metallarox/eload-60v/docs/reports/drc_report.txt

** Drc report for eload_4ch.kicad_pcb **
** Created on 2026-10-26T12:06:38 **
** Report includes: Errors, Warnings, Exclusions **

** Found 4 DRC violations **
[lib_footprint_mismatch]: Footprint 'TO-247-3_Horizontal_TabUp' does not match copy in library 'Package_TO_SOT_THT'
    Local override; warning
    @(94.5500 mm, 130.0000 mm): Footprint Q3
[lib_footprint_mismatch]: Footprint 'TO-247-3_Horizontal_TabUp' does not match copy in library 'Package_TO_SOT_THT'
    Local override; warning
    @(129.4500 mm, 74.0000 mm): Footprint Q2
[lib_footprint_mismatch]: Footprint 'TO-247-3_Horizontal_TabUp' does not match copy in library 'Package_TO_SOT_THT'
    Local override; warning
    @(118.5500 mm, 130.0000 mm): Footprint Q4
[lib_footprint_mismatch]: Footprint 'TO-247-3_Horizontal_TabUp' does not match copy in library 'Package_TO_SOT_THT'
    Local override; warning
    @(105.4500 mm, 74.0000 mm): Footprint Q1

** Found 0 unconnected pads **

** Found 0 Footprint errors **

** Ignored checks **
    - Footprint has no courtyard defined
    - Track endpoint not centered on via
    - Tuning profile track geometries
    - Footprint doesn't match symbol's footprint filters
    - Footprint component type doesn't match footprint pads

** End of Report **
