metallarox/eload-60v/docs/images/closed.png

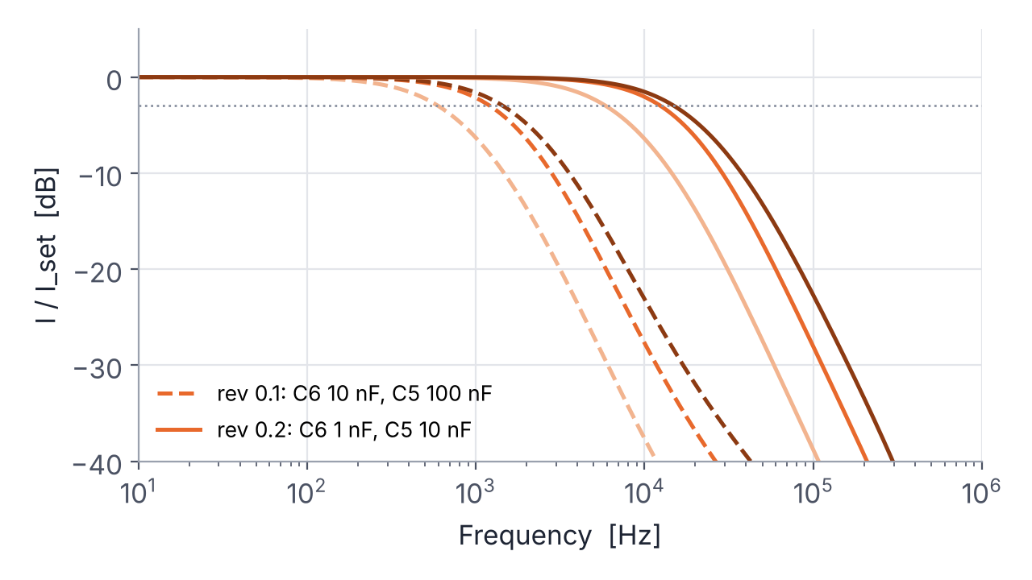
docs/images/closed.png
