metallarox/eload-60v/docs/images/render_bottom.png

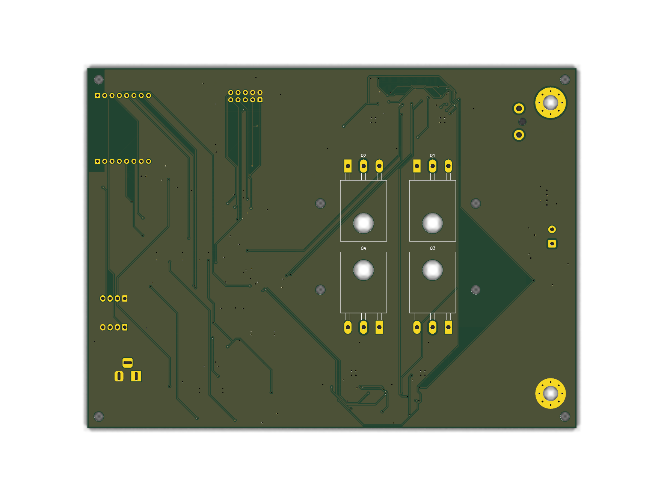
docs/images/render_bottom.png
