metallarox/eload-60v/hardware/bom/eload_4ch_bom.csv

Reference | Qty | Value | Footprint | MPN | Note
C1 | 1 | 100n 100V | Capacitor_SMD:C_1206_3216Metric |  | X7R
C2 | 1 | 10n 100V | Capacitor_SMD:C_1206_3216Metric
C3,C4,C7,C10,C13,C16,C20,C22,C28-C30,C32-C34,C36 | 15 | 100n | Capacitor_SMD:C_1206_3216Metric
C5,C8,C11,C14 | 4 | 10n C0G | Capacitor_SMD:C_1206_3216Metric |  | Setpoint filter 16.6 kHz (rev 0.2)
C6,C9,C12,C15 | 4 | 1n C0G | Capacitor_SMD:C_1206_3216Metric |  | Loop compensation rev 0.2: PM ~80 deg, BW 6-15 kHz
C17,C18,C40,C41 | 4 | 100n 50V | Capacitor_SMD:C_1206_3216Metric
C19,C21,C27,C35,C38,C39 | 6 | 10u 25V | Capacitor_SMD:C_1206_3216Metric |  | OLED decoupling
C23-C26 | 4 | 10n | Capacitor_SMD:C_1206_3216Metric |  | Debounce 100 us
C31,C37 | 2 | 1u | Capacitor_SMD:C_1206_3216Metric
C42,C43 | 2 | 22u 10V | Capacitor_SMD:C_1206_3216Metric
D1 | 1 | VS-30CTQ100S | Package_TO_SOT_SMD:TO-263-2 | VS-30CTQ100SPbF | Reverse polarity: conducts and blows F1 (check I2t)
D2 | 1 | SMCJ64CA | Diode_SMD:D_SMC | SMCJ64CA
D3 | 1 | SMAJ64CA | Diode_SMD:D_SMA | SMAJ64CA
D4 | 1 | SS34 | Diode_SMD:D_SMA | SS34
D5 | 1 | green | LED_SMD:LED_1206_3216Metric
F1 | 1 | 25A ATO | Fuse:Fuseholder_Blade_ATO_Littelfuse_Pudenz_2_Pin |  | ATO blade fuse 25 A
F2 | 1 | 1.5A | Fuse:Fuse_1206_3216Metric |  | PTC 1206, 1.5 A hold (WiFi buck + fan)
J1 | 1 | DUT+ | MountingHole:MountingHole_5.3mm_M5_Pad_Via |  | M5 stud, 25 A
J2 | 1 | DUT- | MountingHole:MountingHole_5.3mm_M5_Pad_Via |  | M5 stud, 25 A - ground star point
J3 | 1 | SENSE | TerminalBlock_Phoenix:TerminalBlock_Phoenix_MKDS-1,5-2_1x02_P5.00mm_Horizontal |  | 1=SENSE+ 2=SENSE-
J4 | 1 | D1mini L | Connector_PinSocket_2.54mm:PinSocket_1x08_P2.54mm_Vertical |  | RST A0 D0(GPIO16) D5(14) D6(12) D7(13) D8(15) 3V3; the module 3V3 powers the logic
J5 | 1 | D1mini R | Connector_PinSocket_2.54mm:PinSocket_1x08_P2.54mm_Vertical |  | TX RX(GPIO3) D1(5) D2(4) D3(0)=expander INT D4(2) G 5V; GPIO0/2/15 = strapping
J6 | 1 | FRONT PANEL | Connector_IDC:IDC-Header_2x05_P2.54mm_Vertical |  | 10-wire ribbon to the front panel: OLED SSD1309/SH1106 0x3C, EC11 encoder, OUTPUT button
J7 | 1 | FAN | Connector_Molex:Molex_KK-254_AE-6410-04A_1x04_P2.54mm_Vertical |  | 12 V 4-wire fan (SP3/TR4 cooler)
J8 | 1 | NTC | Connector_Molex:Molex_KK-254_AE-6410-04A_1x04_P2.54mm_Vertical |  | 2x NTC 10k B3950 glued to the spreader
J9 | 1 | 12V DC | Connector_BarrelJack:BarrelJack_Horizontal
L1 | 1 | 6u8 | Inductor_SMD:L_Bourns-SRN4018 | SRN4018-6R8M
Q1-Q4 | 4 | IXTH75N10L2 | Package_TO_SOT_THT:TO-247-3_Horizontal_TabUp | IXTH75N10L2 | Linear L2 MOSFET 100 V, under the PCB screwed to the spreader (common drain)
Q5-Q7 | 3 | FDS9926A | Package_SO:SOIC-8_3.9x4.9mm_P1.27mm | FDS9926A | ARM -> CLAMP inverter
Q6,Q7 | 2 | FDS9926A | Package_SO:SOIC-8_3.9x4.9mm_P1.27mm |  | Open-drain fan PWM (inverted logic in firmware)
R1,R15,R21,R27,R33,R49 | 6 | 100R | Resistor_SMD:R_1206_3216Metric
R2,R5,R8,R16,R22,R28,R34,R39-R42,R44,R46,R48,R51 | 15 | 10k | Resistor_SMD:R_1206_3216Metric |  | 0.1%,Fallback when sense leads are not connected,Pull-down: ARM low = load disabled
R3 | 1 | 10R | Resistor_SMD:R_1206_3216Metric |  | SENSE- referenced to ground only
R4,R14,R20,R26,R32,R36,R45 | 7 | 1k | Resistor_SMD:R_1206_3216Metric |  | Tach on RX: unplug the fan when programming over USB
R6,R9 | 2 | 1M | Resistor_SMD:R_1206_3216Metric |  | OTP hysteresis,OVP hysteresis
R7 | 1 | 249k | Resistor_SMD:R_1206_3216Metric |  | 1206 >= 200 V
R10,R47,R50,R55 | 4 | 100k | Resistor_SMD:R_1206_3216Metric |  | ARM read-back: 100k, a GPIO driven at boot cannot arm the load
R11 | 1 | 9k31 | Resistor_SMD:R_1206_3216Metric |  | OTP threshold ~100 C
R12,R18,R24,R30 | 4 | 24k 0.1% | Resistor_SMD:R_1206_3216Metric |  | 25:1 divider: 2.5 V -> 100 mV = 5 A
R13,R19,R25,R31 | 4 | 1k 0.1% | Resistor_SMD:R_1206_3216Metric
R17,R23,R29,R35 | 4 | 20m 1% | Resistor_SMD:R_Shunt_Vishay_WSK2512_6332Metric_T1.19mm | WSK2512R0200FEA | 4-terminal Kelvin shunt
R37,R38 | 2 | 2k2 | Resistor_SMD:R_1206_3216Metric |  | Bus extended to the front panel (rev 0.3)
R43 | 1 | 470R | Resistor_SMD:R_1206_3216Metric |  | OUTPUT LED on the panel: anode to 3V3, cathode here
R52,R53 | 2 | 10k 0.1% | Resistor_SMD:R_1206_3216Metric |  | NTC2 spare: the D1 mini has a single ADC (A0 = NTC1)
R54 | 1 | 1k5 | Resistor_SMD:R_1206_3216Metric
U1 | 1 | TL431ID | Package_SO:SOIC-8_3.9x4.9mm_P1.27mm | TL431IDR
U2 | 1 | LM393 | Package_SO:SOIC-8_3.9x4.9mm_P1.27mm | LM393DR
U3,U6 | 2 | OPA2196 | Package_SO:SOIC-8_3.9x4.9mm_P1.27mm | OPA2196IDR
U4,U5,U7,U8 | 4 | INA228 | Package_SO:MSOP-10_3x3mm_P0.5mm | INA228AIDGSR | ALERT open-drain on ARM (over-current / over-power)
U6 | 1 | OPA2196 | Package_SO:SOIC-8_3.9x4.9mm_P1.27mm | OPA2196IDR
U9 | 1 | PCF8574T | Package_SO:SOIC-16W_7.5x10.3mm_P1.27mm | PCF8574T/3 | I2C expander @0x20; INT on GPIO0 (D3)
U10 | 1 | DAC8565 | Package_SO:TSSOP-16_4.4x5mm_P0.65mm | DAC8565IAPW | RSTSEL=0: reset to zero scale; LDAC=0: synchronous update
U11 | 1 | L78L05 | Package_SO:SOIC-8_3.9x4.9mm_P1.27mm | L78L05ACD13TR
U12 | 1 | AP63205WU | Package_TO_SOT_SMD:TSOT-23-6 | AP63205WU-7 | FB tied to the 5 V output (fixed-output version)
