metallarox/eload-60v/hardware/bom/eload_4ch_bom_priced.xlsx

Sheet: BOM
BOM con prezzi — Carico attivo 60 V / 20 A / 300 W, 4 canali (controllo WiFi Wemos D1 mini Pro) — rev 0.3
Prezzi IVA esclusa, a quantità singola. Celle blu = valori inseriti a mano; cambi e numero di schede nel foglio Parametri.
Categoria | Riferimenti | Q.tà/scheda | Valore | Package | MPN proposto | Distributore | Prezzo unit. | Valuta | Prezzo unit. € | Q.tà totale | Totale € | Stato prezzo | Fonte | Note
Condensatori | C1 | 1 | 100n 100V X7R | 1206 | CC1206KKX7R0BB104 (Yageo) | Comet | 0.0242 | USD | 0.0208 € | 1 | 0.02 € | verificato | https://store.comet.bg/en/Catalogue/Product/37095 | Prezzo a 10 pz
Condensatori | C2 | 1 | 10n 100V X7R | 1206 | generico X7R 100V | LCSC | 0.0200 | USD | 0.0172 € | 1 | 0.02 € | stima
Condensatori | C3,C4,C7,C10,C13,C16,C20,C22,C28-C30,C32-C34,C36 | 15 | 100n | 1206 | 1206B104K500CT (Walsin) o equiv. | LCSC | 0.0150 | USD | 0.0129 € | 15 | 0.19 € | stima | https://www.lcsc.com/product-detail/C93194.html | Usare 100 V dove il nodo vede VLOAD
Condensatori | C5,C8,C11,C14 | 4 | 10n C0G | 1206 | generico C0G/NP0 50V | LCSC | 0.0300 | USD | 0.0258 € | 4 | 0.10 € | stima |  | Filtro setpoint 16,6 kHz (rev 0.2)
Condensatori | C6,C9,C12,C15 | 4 | 1n C0G | 1206 | generico C0G/NP0 50V | LCSC | 0.0200 | USD | 0.0172 € | 4 | 0.07 € | stima |  | Compensazione loop (rev 0.2)
Condensatori | C17,C18,C40,C41 | 4 | 100n 50V | 1206 | 1206B104K500CT (Walsin) | LCSC | 0.0150 | USD | 0.0129 € | 4 | 0.05 € | stima | https://www.lcsc.com/product-detail/C93194.html
Condensatori | C19,C21,C27,C35,C38,C39 | 6 | 10u 25V | 1206 | 10u 50V X7R 1206 | LCSC | 0.0667 | USD | 0.0574 € | 6 | 0.34 € | verificato | https://www.lcsc.com/category/1142.html | Prezzo a 10 pz, parte da 50 V
Condensatori | C31,C37 | 2 | 1u | 1206 | generico X7R 50V | LCSC | 0.0200 | USD | 0.0172 € | 2 | 0.03 € | stima
Condensatori | C23-C26 | 4 | 10n | 1206 | generico X7R 50V | LCSC | 0.0100 | USD | 0.0086 € | 4 | 0.03 € | stima |  | Antirimbalzo pannello (rev 0.3)
Condensatori | C42,C43 | 2 | 22u 10V | 1206 | generico X5R/X7R 10V | LCSC | 0.0500 | USD | 0.0430 € | 2 | 0.09 € | stima |  | Uscita buck
Diodi | D1 | 1 | Schottky 100V 30A | TO-263 | VS-30CTQ100SPbF | LCSC | 3.5052 | USD | 3.0145 € | 1 | 3.01 € | verificato | https://www.lcsc.com/product-image/C145332.html | Stock molto basso
Diodi | D2 | 1 | TVS 64V 1500W | SMC | SMCJ64CA | LCSC | 0.2500 | USD | 0.2150 € | 1 | 0.21 € | stima
Diodi | D3 | 1 | TVS 64V 400W | SMA | SMAJ64CA | LCSC | 0.0800 | USD | 0.0688 € | 1 | 0.07 € | stima
Diodi | D4 | 1 | Schottky 40V 3A | SMA | SS34 | LCSC | 0.0300 | USD | 0.0258 € | 1 | 0.03 € | stima
Diodi | D5 | 1 | LED verde | 1206 | generico | LCSC | 0.0300 | USD | 0.0258 € | 1 | 0.03 € | stima
Protezioni | F1 | 1 | Fusibile ATO 25A | lamellare | 0287025.PXCN (Littelfuse) | RS UK | 0.2350 | GBP | 0.2702 € | 1 | 0.27 € | verificato | https://uk.rs-online.com/web/p/car-fuses/7874154 | Confezione da 10
Protezioni | F1 (portafusibile) | 1 | Portafusibile ATO PCB | THT 2 pin | Littelfuse/Pudenz 2-pin |  |  | EUR |  | 1 |  | da quotare |  | Verificare MPN contro footprint
Protezioni | F2 | 1 | PTC 1,5A hold | 1206 | PTC 1206 hold 1,5 A | LCSC | 0.1500 | USD | 0.1290 € | 1 | 0.13 € | stima |  | Alzato da 500 mA: ora alimenta buck WiFi + ventola
Connettori | J1,J2 | 2 | Morsetto M5 (bullone) | foro 5,3 mm | Bullone M5 inox + 2 dadi + rondelle | Ferramenta | 0.6000 | EUR | 0.6000 € | 2 | 1.20 € | stima |  | Alternativa: Würth REDCUBE M5 7461383 (~2,50 USD, footprint da cambiare)
Connettori | J3 | 1 | Morsetto 2 vie 5 mm | THT | Phoenix MKDS 1,5/2 (1715022) |  | 0.8000 | EUR | 0.8000 € | 1 | 0.80 € | stima
Connettori | J4,J5 | 2 | Strip femmina 1x8 2,54 | THT | generico | LCSC | 0.3000 | USD | 0.2580 € | 2 | 0.52 € | stima |  | Zoccolo per il Wemos
Connettori | J6 | 1 | Header IDC 2x5 2,54 | THT | IDC-Header 2x05 verticale | LCSC | 0.3000 | USD | 0.2580 € | 1 | 0.26 € | stima |  | Pannello frontale (rev 0.3)
Connettori | J7,J8 | 2 | Molex KK 4 vie | THT | 22-27-2041 |  | 0.3500 | USD | 0.3010 € | 2 | 0.60 € | stima
Connettori | J9 | 1 | Jack DC | THT | PJ-102AH (CUI) |  | 0.6000 | USD | 0.5160 € | 1 | 0.52 € | stima
Modulo WiFi | (su J4/J5) | 1 | Wemos LOLIN D1 mini Pro V2 | modulo | LOLIN D1 mini Pro V2 (ESP8266, 16 MB, U.FL) | TinyTronics | 7.4400 | EUR | 7.4400 € | 1 | 7.44 € | verificato | https://www.tinytronics.nl/shop/nl/communicatie/wi-fi/wemos-lolin-d1-mini-pro-v2-esp8266-ch340c | IVA esclusa; cloni a pochi euro su AliExpress
Magnetici | L1 | 1 | 6,8 µH | 4x4 mm | SRN4018-6R8M (Bourns) |  | 0.3000 | USD | 0.2580 € | 1 | 0.26 € | stima
Transistor | Q1,Q2,Q3,Q4 | 4 | MOSFET Linear L2 100V 75A | TO-247 | IXTH75N10L2 | DigiKey | 17.5900 | USD | 15.1274 € | 4 | 60.51 € | verificato | https://www.findchips.com/search/H75N1 | 1 pz; 10,93 USD da 30 pz. Mouser 20,99 USD
Transistor | Q5,Q6,Q7 | 3 | Dual N-MOSFET | SOIC-8 | FDS9926A |  | 0.4000 | USD | 0.3440 € | 3 | 1.03 € | stima
Resistori | R1,R15,R21,R27,R33,R49 | 6 | 100R 1% | 1206 | generico | LCSC | 0.0050 | USD | 0.0043 € | 6 | 0.03 € | stima
Resistori | R2,R5,R8,R16,R22,R28,R34,R39-R42,R44,R46,R48,R51 | 15 | 10k 1% | 1206 | generico | LCSC | 0.0050 | USD | 0.0043 € | 15 | 0.06 € | stima
Resistori | R3 | 1 | 10R 1% | 1206 | generico | LCSC | 0.0050 | USD | 0.0043 € | 1 | 0.0043 € | stima
Resistori | R4,R14,R20,R26,R32,R36,R45 | 7 | 1k 1% | 1206 | generico | LCSC | 0.0050 | USD | 0.0043 € | 7 | 0.03 € | stima
Resistori | R6,R9 | 2 | 1M 1% | 1206 | generico | LCSC | 0.0050 | USD | 0.0043 € | 2 | 0.01 € | stima
Resistori | R7 | 1 | 249k 1% | 1206 | generico (≥200 V) | LCSC | 0.0050 | USD | 0.0043 € | 1 | 0.0043 € | stima
Resistori | R10,R47,R50,R55 | 4 | 100k 1% | 1206 | generico | LCSC | 0.0050 | USD | 0.0043 € | 4 | 0.02 € | stima
Resistori | R11 | 1 | 9k31 1% | 1206 | generico | LCSC | 0.0050 | USD | 0.0043 € | 1 | 0.0043 € | stima
Resistori | R12,R18,R24,R30 | 4 | 24k 0,1% | 1206 | thin film 0,1% 25 ppm | LCSC | 0.2500 | USD | 0.2150 € | 4 | 0.86 € | stima |  | Partitore 25:1
Resistori | R13,R19,R25,R31 | 4 | 1k 0,1% | 1206 | thin film 0,1% 25 ppm | LCSC | 0.2500 | USD | 0.2150 € | 4 | 0.86 € | stima
Resistori | R17,R23,R29,R35 | 4 | Shunt 20 mΩ Kelvin | 2512 4T | WSK2512R0200FEA (Vishay) | element14 CN | 23.7200 | CNY | 2.8464 € | 4 | 11.39 € | verificato | https://www.element14.cn/en-CN/vishay/wsk2512r0200fea/current-sense-res-0r02-1-1-w-2512/dp/1107431 | Prezzo a 5 pz, IVA esclusa
Resistori | R37,R38 | 2 | 2k2 1% | 1206 | generico | LCSC | 0.0050 | USD | 0.0043 € | 2 | 0.01 € | stima
Resistori | R43 | 1 | 470R 1% | 1206 | generico | LCSC | 0.0050 | USD | 0.0043 € | 1 | 0.0043 € | stima |  | LED OUTPUT
Resistori | R52,R53 | 2 | 10k 0,1% | 1206 | thin film 0,1% | LCSC | 0.2500 | USD | 0.2150 € | 2 | 0.43 € | stima
Resistori | R54 | 1 | 1k5 1% | 1206 | generico | LCSC | 0.0050 | USD | 0.0043 € | 1 | 0.0043 € | stima
Integrati | U1 | 1 | Riferimento shunt | SOIC-8 | TL431IDR |  | 0.1000 | USD | 0.0860 € | 1 | 0.09 € | stima
Integrati | U2 | 1 | Comparatore doppio | SOIC-8 | LM393DR |  | 0.1000 | USD | 0.0860 € | 1 | 0.09 € | stima
Integrati | U3,U6 | 2 | Op-amp doppio 36V | SOIC-8 | OPA2196IDR | Mouser | 2.3900 | USD | 2.0554 € | 2 | 4.11 € | verificato | https://www.flux.ai/lcsc/opa2196idr.md
Integrati | U4,U5,U7,U8 | 4 | Monitor I/V/P 20 bit | MSOP-10 | INA228AIDGSR | DigiKey | 4.5400 | USD | 3.9044 € | 4 | 15.62 € | verificato | https://www.digikey.com/en/products/detail/texas-instruments/INA228AIDGST/13691047 | Prezzo indicato come sostituto consigliato della variante DGST
Integrati | U9 | 1 | Espansore I/O I2C | SOIC-16W | PCF8574T/3 (NXP) |  | 1.0000 | USD | 0.8600 € | 1 | 0.86 € | stima |  | @0x20, pannello frontale
Integrati | U10 | 1 | DAC 4ch 16 bit | TSSOP-16 | DAC8565IAPW | Mouser | 14.7500 | USD | 12.6850 € | 1 | 12.69 € | verificato | https://www.electronicsdatasheets.com/manufacturers/texas-instruments/parts/dac8565 | LCSC: IAPWR 11,80 USD ma NRND
Integrati | U11 | 1 | LDO 5V 100mA (analogico) | SOIC-8 | L78L05ACD13TR |  | 0.1500 | USD | 0.1290 € | 1 | 0.13 € | stima
Integrati | U12 | 1 | Buck 5V 2A | TSOT-23-6 | AP63205WU-7 (Diodes) | Mouser | 0.7100 | USD | 0.6106 € | 1 | 0.61 € | verificato | https://www.oemstrade.com/search/ap63205wu-7
PCB | PCB | 1 | 2 strati, 2 oz, FR4 1,6 mm | — | JLCPCB (5 pz min.) | JLCPCB |  | USD |  | 1 |  | da quotare | https://jlcpcb.com | Quotare sul configuratore: il prezzo dipende da dimensioni e opzione 2 oz
 |  |  |  |  |  |  |  |  |  | Totale elettronica | 125.73 €
 |  |  |  |  |  |  |  |  |  | di cui verificato | 116.01 €
 |  |  |  |  |  |  |  |  |  | di cui stima | 9.72 €
 |  |  |  |  |  |  |  |  |  | Righe da quotare | 2
 |  |  |  |  |  |  |  |  |  | Subtotale per categoria
 |  |  |  |  |  |  |  |  |  | Condensatori | 0.95 €
 |  |  |  |  |  |  |  |  |  | Diodi | 3.35 €
 |  |  |  |  |  |  |  |  |  | Protezioni | 0.40 €
 |  |  |  |  |  |  |  |  |  | Connettori | 3.89 €
 |  |  |  |  |  |  |  |  |  | Modulo WiFi | 7.44 €
 |  |  |  |  |  |  |  |  |  | Magnetici | 0.26 €
 |  |  |  |  |  |  |  |  |  | Transistor | 61.54 €
 |  |  |  |  |  |  |  |  |  | Resistori | 13.71 €
 |  |  |  |  |  |  |  |  |  | Integrati | 34.19 €
 |  |  |  |  |  |  |  |  |  | PCB | 0.00 €
 |  |  |  |  |  |  |  |  |  | Totale meccanica | 41.50 €
 |  |  |  |  |  |  |  |  |  | TOTALE (righe con prezzo) | 167.23 €

Sheet: Meccanica
Meccanica e accessori (opzionale, non sulla PCB)
Categoria | Descrizione | Q.tà/scheda | Unità | Prezzo unit. | Valuta | Stato prezzo | Fonte | Note | Prezzo unit. € | Q.tà totale | Totale €
Termica | Dissipatore + ventola 12 V 4 fili (cooler socket SP3/TR4, ≥300 W) | 1 |  |  | EUR | da quotare |  | Il PCB è progettato sopra questo cooler |  | 1
Termica | Spreader in rame (piatto Cu-ETP, spessore 6 mm, a misura) | 1 |  |  | EUR | da quotare |  | A potenziale VLOAD: va isolato dal cooler |  | 1
Termica | Pad termico isolante fra spreader e cooler | 1 |  |  | EUR | da quotare |  | Deve reggere ≥ 100 V |  | 1
Termica | NTC 10k B3950 (2 pz, incollate allo spreader) | 2 |  | 0.5 | EUR | stima |  |  | 0.50 € | 2 | 1.00 €
Termica | Pasta termica (MOSFET → spreader) | 1 |  | 5 | EUR | stima |  |  | 5.00 € | 1 | 5.00 €
Meccanica | Viti M3 + distanziali in nylon | 1 | set | 3 | EUR | stima |  |  | 3.00 € | 1 | 3.00 €
Alimentazione | Alimentatore 12 V ≥ 2 A con jack 5,5/2,1 | 1 |  | 10 | EUR | stima |  |  | 10.00 € | 1 | 10.00 €
Pannello frontale | OLED 2,42" 128x64 I2C (SSD1309) o 1,3" SH1106 | 1 |  | 12 | EUR | stima |  | Indirizzo 0x3C | 12.00 € | 1 | 12.00 €
Pannello frontale | Encoder EC11 con pulsante + manopola | 1 |  | 3 | EUR | stima |  |  | 3.00 € | 1 | 3.00 €
Pannello frontale | Pulsante OUTPUT con LED | 1 |  | 2.5 | EUR | stima |  |  | 2.50 € | 1 | 2.50 €
Pannello frontale | Flat 10 poli + 2 connettori IDC 2x5 | 1 |  | 2 | EUR | stima |  | Max ~20 cm | 2.00 € | 1 | 2.00 €
Modulo WiFi | Antenna 2,4 GHz con cavetto U.FL (opzionale, se il case è metallico) | 1 |  | 3 | EUR | stima |  |  | 3.00 € | 1 | 3.00 €
 |  |  |  |  |  |  |  |  |  | Totale meccanica | 41.50 €

Sheet: Parametri
Parametri e ipotesi
Cambio USD → EUR | 0.860 | Ipotesi, da aggiornare al giorno dell'ordine
Cambio GBP → EUR | 1.150 | Ipotesi, da aggiornare
Cambio CNY → EUR | 0.120 | Ipotesi, da aggiornare (prezzi element14 CN sono IVA esclusa)
Numero di schede | 1 | Moltiplica tutte le quantità della BOM
Note
• Prezzi a quantità singola/piccola (1–10 pz), IVA esclusa, spedizione e dazi esclusi. Rilevati fra ottobre 2025 e ottobre 2026 dalle pagine indicate nella colonna Fonte: vanno riverificati prima dell'ordine.
• Stato 'verificato' = prezzo letto su una pagina distributore; 'stima' = prezzo tipico di mercato per quella classe di componente, non letto su una pagina; 'da quotare' = nessun riferimento affidabile.
• Passivi 1206: il prezzo unitario è basso ma molti distributori vendono a multipli di 10–50 pz; il costo reale d'acquisto dei passivi è dominato dai minimi d'ordine (qualche euro in totale).
• IXTH75N10L2: lead time di fabbrica 21–38 settimane secondo DigiKey; verificare la disponibilità a magazzino prima di confermare il progetto.
• Controllo via WiFi con Wemos LOLIN D1 mini Pro V2 (ESP8266) su strip femmina: l'USB del modulo NON è isolato, usarlo solo per programmare a DUT scollegato. Il modulo V2 è lungo 48 mm: l'antenna sporge di circa 2 cm oltre il bordo destro del PCB.
• DAC8565IAPWR risulta 'Not recommended for new designs' su LCSC; la variante in tubo DAC8565IAPW è ancora in vendita su Mouser/DigiKey.
• VS-30CTQ100SPbF: LCSC mostrava 1 solo pezzo a magazzino; tenere un'alternativa D2PAK 100 V ≥ 30 A.
• PCB JLCPCB 2 strati / 2 oz: traccia/spazio minimo 8 mil (0,2 mm), mentre le piazzole dell'INA228 (MSOP-10) distano 0,15 mm. Verificare con il configuratore o passare a 1 oz sugli strati esterni con ricopertura.
• J1/J2: il footprint attuale è un foro M5 con piazzola, quindi la BOM prevede bullone M5 + dadi + rondelle. I terminali Würth REDCUBE press-fit sono un'alternativa migliore per 25 A ma richiedono un footprint diverso.
• Q5–Q7: il CSV di KiCad duplicava la riga per i simboli multi-unità; qui sono consolidati in 3 package FDS9926A. Idem U3/U6 = 2 package OPA2196.
• Rispetto alla versione con STM32 sono usciti STM32F042, ADuM3160, USB-B, LP2951 e header SWD (circa 12 € in meno di elettronica, più il modulo Wemos).
