metallarox/eload-60v/docs/images/step.png

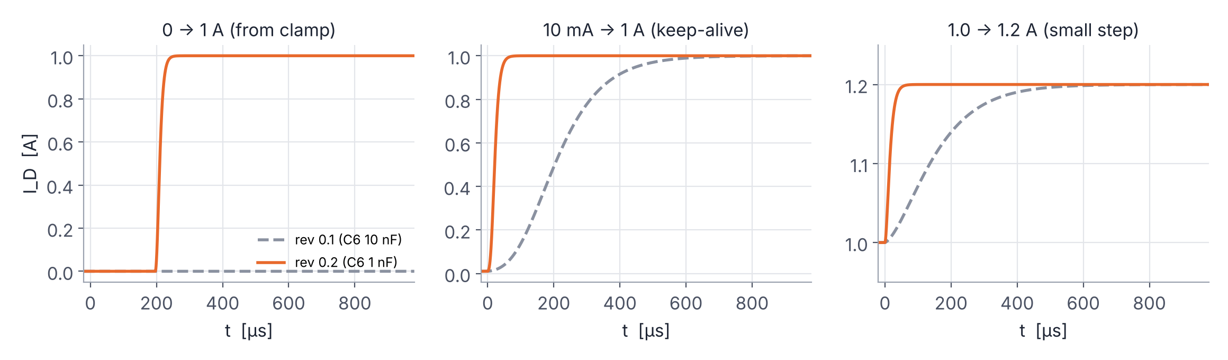
docs/images/step.png
