metallarox/eload-60v/docs/eload_4ch_pcb.pdf

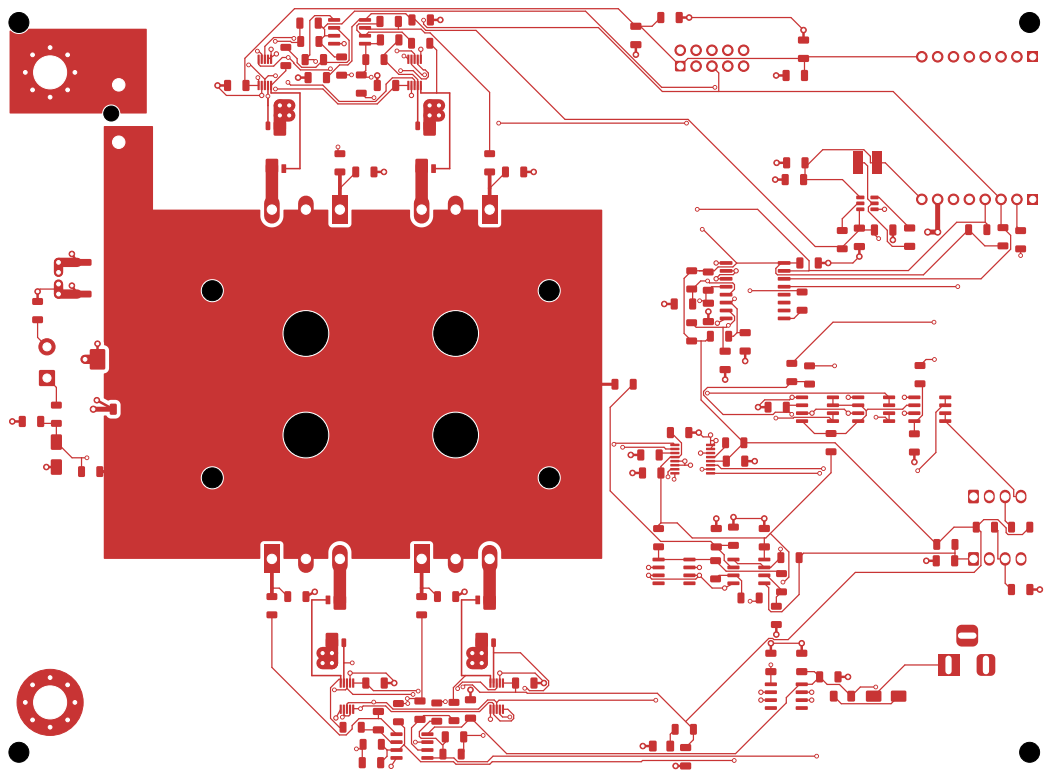
[picture p32: page 1]

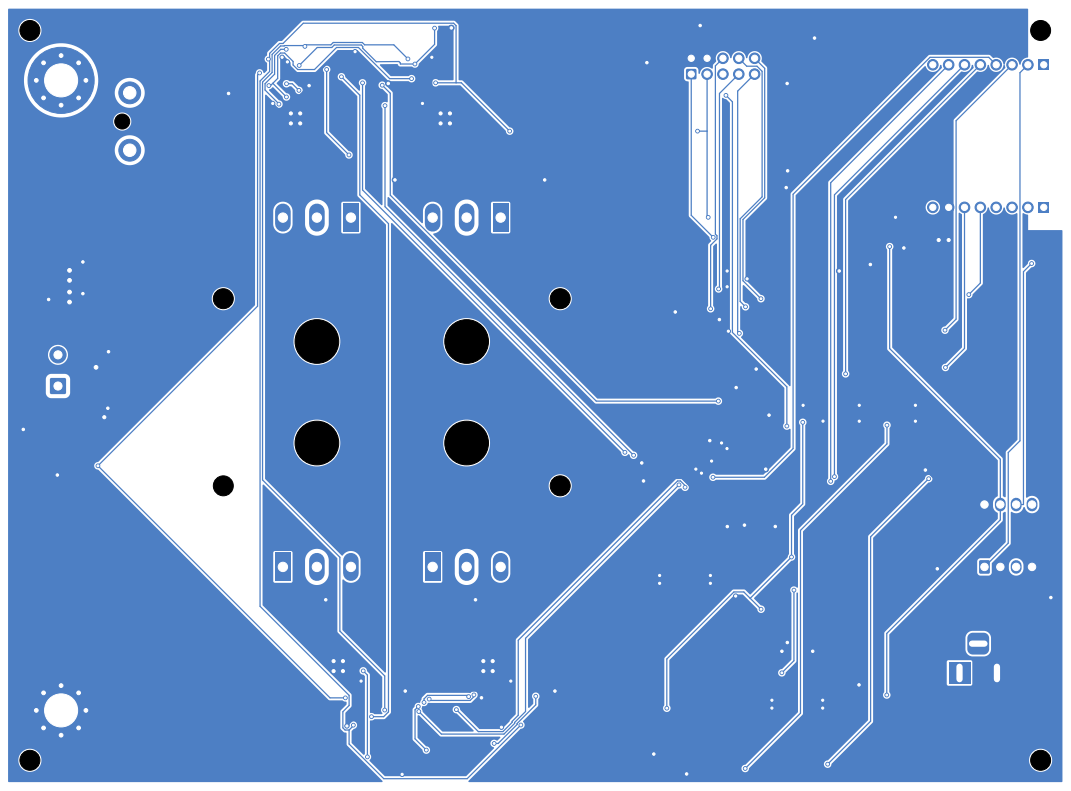
[picture p33: page 2]

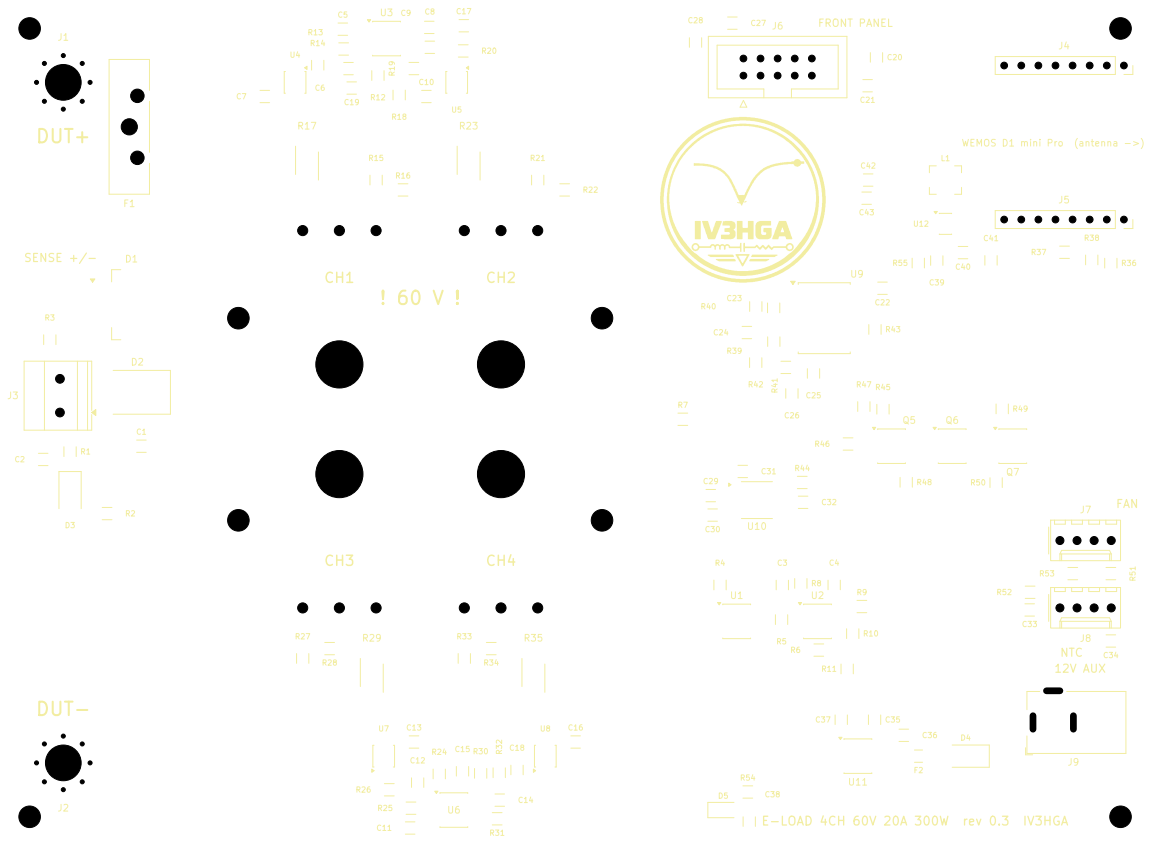
[picture p34: page 3]

WEMOS D1 mini Pro (antenna ->) FRONT PANEL SENSE +/-

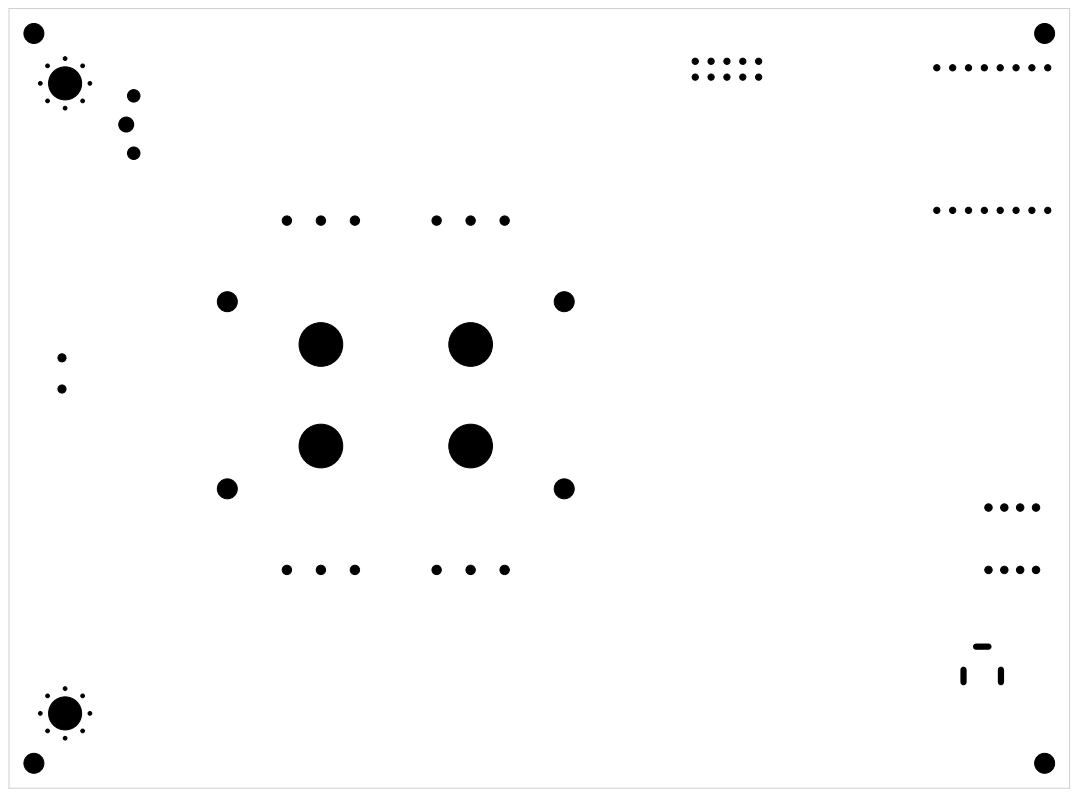
[picture p35: page 4]
