metallarox/eload-60v/docs/assembly/assembly_bottom.pdf

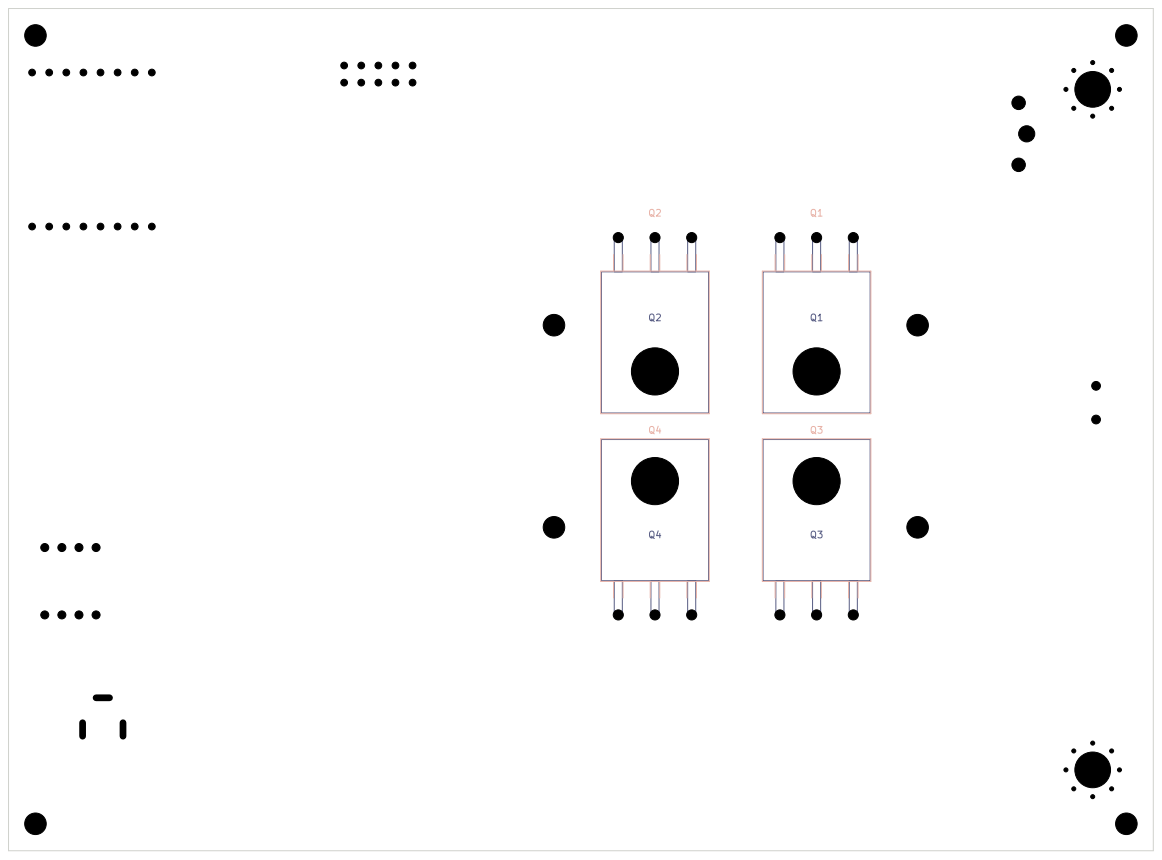
[picture p36: page 1]
