metallarox/eload-60v/docs/assembly/assembly_top.pdf

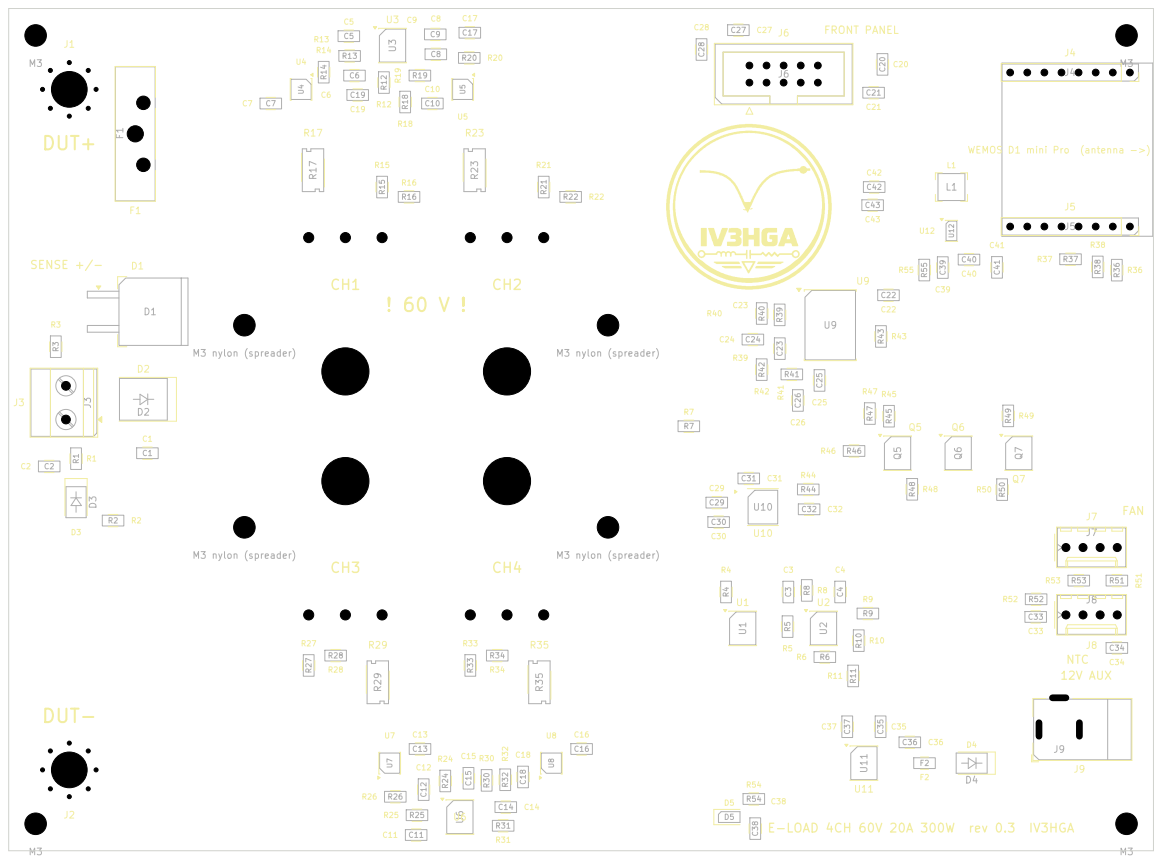
[picture p37: page 1]
