metallarox/eload-60v/hardware/kicad/eload_4ch.kicad_pcb

## KiCad design hardware/kicad/eload_4ch.kicad_pcb (2026-10-26)

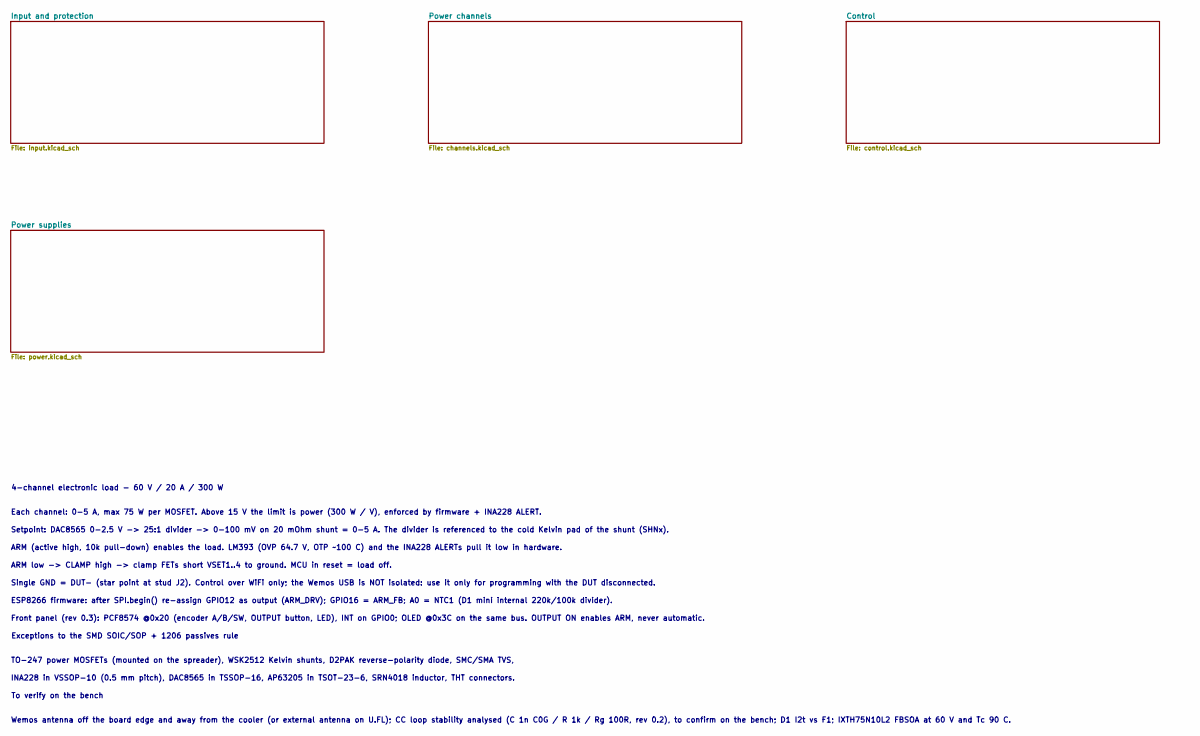
[picture p38: schematic eload_4ch.kicad_sch, Electronic Load 4ch 60V 20A 300W — Index]

Notes on the sheet:
Wemos antenna off the board edge and away from the cooler (or external antenna on U.FL); CC loop stability analysed (C 1n C0G / R 1k / Rg 100R, rev 0.2), to confirm on the bench; D1 I2t vs F1; IXTH75N10L2 FBSOA at 60 V and Tc 90 C.
INA228 in VSSOP-10 (0.5 mm pitch), DAC8565 in TSSOP-16, AP63205 in TSOT-23-6, SRN4018 inductor, THT connectors.
ARM low -> CLAMP high -> clamp FETs short VSET1..4 to ground. MCU in reset = load off.
Front panel (rev 0.3): PCF8574 @0x20 (encoder A/B/SW, OUTPUT button, LED), INT on GPIO0; OLED @0x3C on the same bus. OUTPUT ON enables ARM, never automatic.
Setpoint: DAC8565 0-2.5 V -> 25:1 divider -> 0-100 mV on 20 mOhm shunt = 0-5 A. The divider is referenced to the cold Kelvin pad of the shunt (SHNx).
4-channel electronic load - 60 V / 20 A / 300 W
To verify on the bench
ESP8266 firmware: after SPI.begin() re-assign GPIO12 as output (ARM_DRV); GPIO16 = ARM_FB; A0 = NTC1 (D1 mini internal 220k/100k divider).
Single GND = DUT- (star point at stud J2). Control over WiFi only; the Wemos USB is NOT isolated: use it only for programming with the DUT disconnected.
ARM (active high, 10k pull-down) enables the load. LM393 (OVP 64.7 V, OTP ~100 C) and the INA228 ALERTs pull it low in hardware.
Each channel: 0-5 A, max 75 W per MOSFET. Above 15 V the limit is power (300 W / V), enforced by firmware + INA228 ALERT.
Exceptions to the SMD SOIC/SOP + 1206 passives rule
TO-247 power MOSFETs (mounted on the spreader), WSK2512 Kelvin shunts, D2PAK reverse-polarity diode, SMC/SMA TVS,

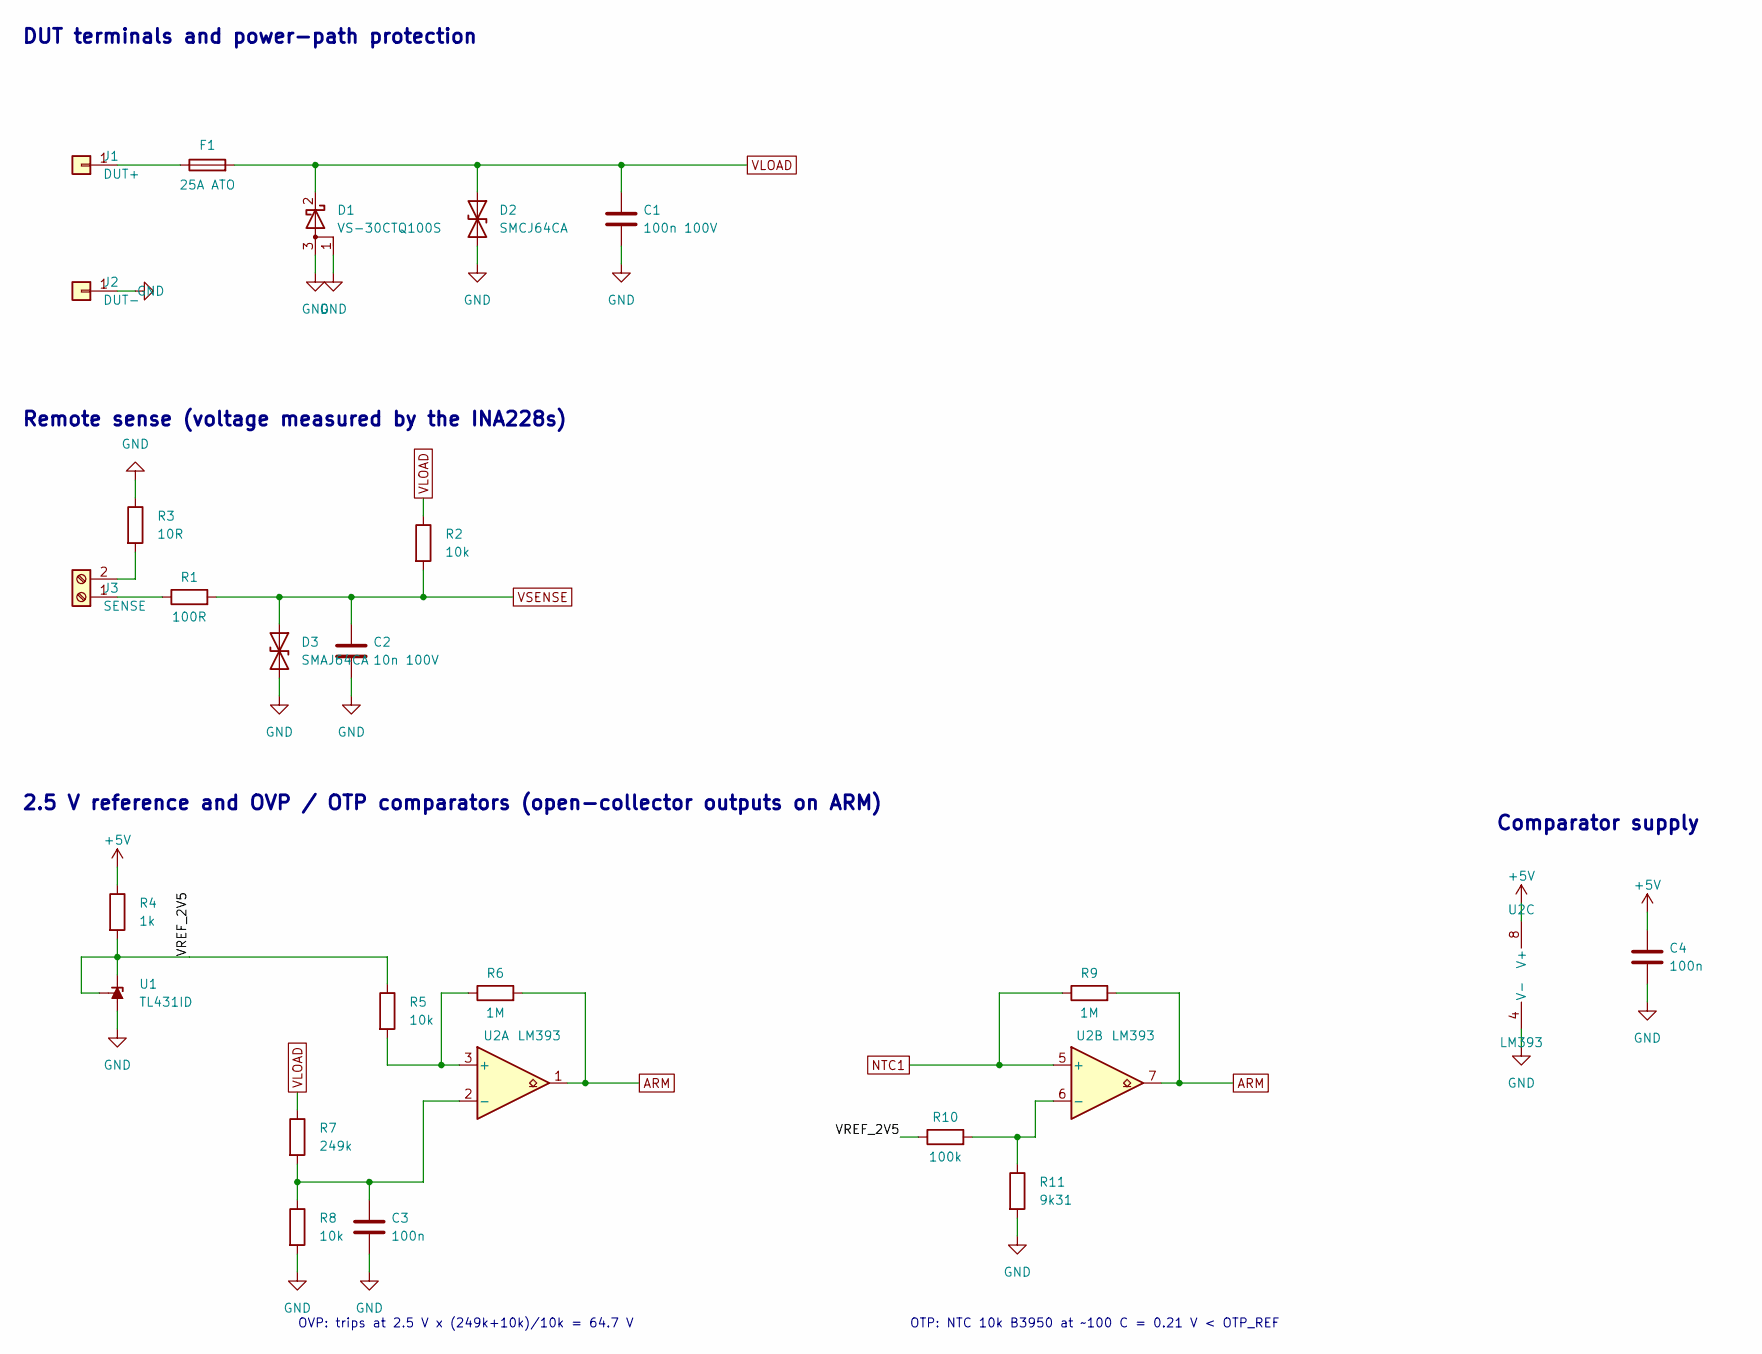
[picture p39: schematic input.kicad_sch, Electronic Load 4ch 60V 20A 300W — Input and protection]

Parts:
C1: 100n 100V; C_1206_3216Metric
C2: 10n 100V; C_1206_3216Metric
C3, C4: 100n; C_1206_3216Metric
D1: VS-30CTQ100S; TO-263-2; MPN VS-30CTQ100SPbF
D2: SMCJ64CA; D_SMC; MPN SMCJ64CA
D3: SMAJ64CA; D_SMA; MPN SMAJ64CA
F1: 25A ATO; Fuseholder_Blade_ATO_Littelfuse_Pudenz_2_Pin
J1: DUT+; MountingHole_5.3mm_M5_Pad_Via
J2: DUT-; MountingHole_5.3mm_M5_Pad_Via
J3: SENSE; TerminalBlock_Phoenix_MKDS-1,5-2_1x02_P5.00mm_Horizontal
R1: 100R; R_1206_3216Metric
R2, R5, R8: 10k; R_1206_3216Metric
R3: 10R; R_1206_3216Metric
R4: 1k; R_1206_3216Metric
R6, R9: 1M; R_1206_3216Metric
R7: 249k; R_1206_3216Metric
R10: 100k; R_1206_3216Metric
R11: 9k31; R_1206_3216Metric
U1: TL431ID; SOIC-8_3.9x4.9mm_P1.27mm; MPN TL431IDR
U2: LM393; SOIC-8_3.9x4.9mm_P1.27mm; MPN LM393DR

Connections:
+5V: C4.1, R4.1, U2.8 (V+); also elsewhere on the board
/Input and protection/VREF_2V5: R4.2, R5.1, R10.1, U1.1 (K), U1.8 (REF)
ARM: R6.2, R9.2, U2.1, U2.7; also elsewhere on the board
GND: C1.2, C2.2, C3.2, C4.2, D1.1 (A), D1.3 (A), D2.2 (A2), D3.2 (A2), J2.1, R3.1, R8.2, R11.2, U1.2, U1.3, U1.6, U1.7, U1.[2,3,6,7] (A), U2.4 (V-); also elsewhere on the board
NTC1: R9.1, U2.5 (+); also elsewhere on the board
unnamed: F1.1, J1.1
unnamed: J3.1, R1.1
unnamed: J3.2, R3.2
unnamed: R5.2, R6.1, U2.3 (+)
unnamed: C3.1, R7.2, R8.1, U2.2 (-)
unnamed: R10.2, R11.1, U2.6 (-)
VLOAD: C1.1, D1.2 (K), D2.1 (A1), F1.2, R2.1, R7.1; also elsewhere on the board
VSENSE: C2.1, D3.1 (A1), R1.2, R2.2; also elsewhere on the board

Notes on the sheet:
DUT terminals and power-path protection
Remote sense (voltage measured by the INA228s)
2.5 V reference and OVP / OTP comparators (open-collector outputs on ARM)
OVP: trips at 2.5 V x (249k+10k)/10k = 64.7 V
OTP: NTC 10k B3950 at ~100 C = 0.21 V < OTP_REF
Comparator supply

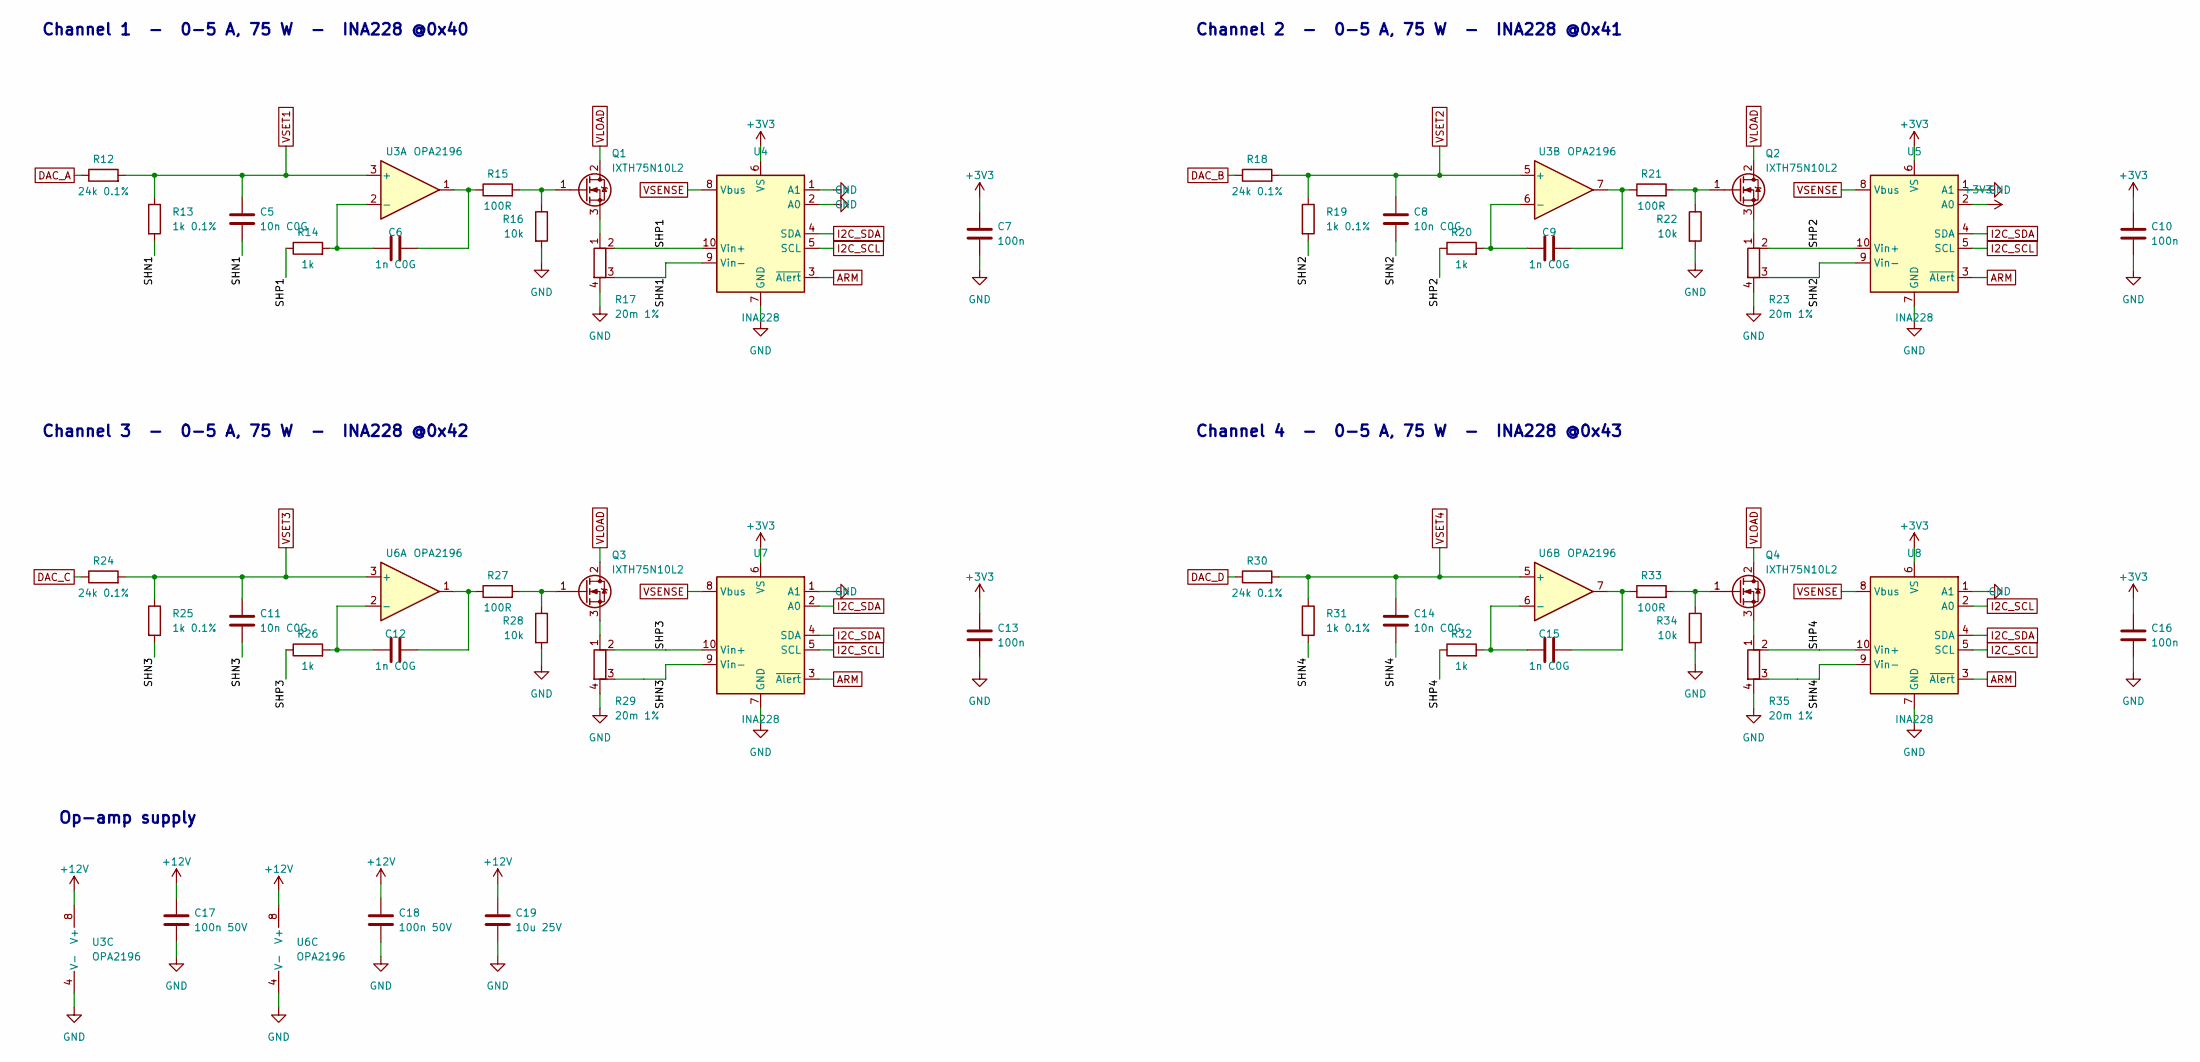
[picture p40: schematic channels.kicad_sch, Electronic Load 4ch 60V 20A 300W — Power channels]

Parts:
C5, C8, C11, C14: 10n C0G; C_1206_3216Metric
C6, C9, C12, C15: 1n C0G; C_1206_3216Metric
C7, C10, C13, C16: 100n; C_1206_3216Metric
C17, C18: 100n 50V; C_1206_3216Metric
C19: 10u 25V; C_1206_3216Metric
Q1, Q2, Q3, Q4: IXTH75N10L2; TO-247-3_Horizontal_TabUp; MPN IXTH75N10L2
R12, R18, R24, R30: 24k 0.1%; R_1206_3216Metric
R13, R19, R25, R31: 1k 0.1%; R_1206_3216Metric
R14, R20, R26, R32: 1k; R_1206_3216Metric
R15, R21, R27, R33: 100R; R_1206_3216Metric
R16, R22, R28, R34: 10k; R_1206_3216Metric
R17, R23, R29, R35: 20m 1%; R_Shunt_Vishay_WSK2512_6332Metric_T1.19mm; MPN WSK2512R0200FEA
U3, U6: OPA2196; SOIC-8_3.9x4.9mm_P1.27mm; MPN OPA2196IDR
U4, U5, U7, U8: INA228; MSOP-10_3x3mm_P0.5mm; MPN INA228AIDGSR

Connections:
+3V3: C7.1, C10.1, C13.1, C16.1, U4.6 (VS), U5.2 (A0), U5.6 (VS), U7.6 (VS), U8.6 (VS); also elsewhere on the board
+12V: C17.1, C18.1, C19.1, U3.8 (V+), U6.8 (V+); also elsewhere on the board
/Power channels/SHN1: C5.2, R13.2, R17.3, U4.9 (Vin-)
/Power channels/SHN2: C8.2, R19.2, R23.3, U5.9 (Vin-)
/Power channels/SHN3: C11.2, R25.2, R29.3, U7.9 (Vin-)
/Power channels/SHN4: C14.2, R31.2, R35.3, U8.9 (Vin-)
/Power channels/SHP1: R14.1, R17.2, U4.10 (Vin+)
/Power channels/SHP2: R20.1, R23.2, U5.10 (Vin+)
/Power channels/SHP3: R26.1, R29.2, U7.10 (Vin+)
/Power channels/SHP4: R32.1, R35.2, U8.10 (Vin+)
ARM: U4.3 (~Alert), U5.3 (~Alert), U7.3 (~Alert), U8.3 (~Alert); also elsewhere on the board
DAC_A: R12.1; also elsewhere on the board
DAC_B: R18.1; also elsewhere on the board
DAC_C: R24.1; also elsewhere on the board
DAC_D: R30.1; also elsewhere on the board
GND: C7.2, C10.2, C13.2, C16.2, C17.2, C18.2, C19.2, R16.2, R17.4, R22.2, R23.4, R28.2, R29.4, R34.2, R35.4, U3.4 (V-), U4.1 (A1), U4.2 (A0), U4.7 (GND), U5.1 (A1), U5.7 (GND), U6.4 (V-), U7.1 (A1), U7.7 (GND), U8.1 (A1), U8.7 (GND); also elsewhere on the board
I2C_SCL: U4.5 (SCL), U5.5 (SCL), U7.5 (SCL), U8.2 (A0), U8.5 (SCL); also elsewhere on the board
I2C_SDA: U4.4 (SDA), U5.4 (SDA), U7.2 (A0), U7.4 (SDA), U8.4 (SDA); also elsewhere on the board
unnamed: C6.2, R15.1, U3.1
unnamed: C9.2, R21.1, U3.7
unnamed: C12.2, R27.1, U6.1
unnamed: C15.2, R33.1, U6.7
unnamed: Q1.1 (G), R15.2, R16.1
unnamed: Q1.3 (S), R17.1
unnamed: Q2.1 (G), R21.2, R22.1
unnamed: Q2.3 (S), R23.1
unnamed: Q3.1 (G), R27.2, R28.1
unnamed: Q3.3 (S), R29.1
unnamed: Q4.1 (G), R33.2, R34.1
unnamed: Q4.3 (S), R35.1
unnamed: C6.1, R14.2, U3.2 (-)
unnamed: C9.1, R20.2, U3.6 (-)
unnamed: C12.1, R26.2, U6.2 (-)
unnamed: C15.1, R32.2, U6.6 (-)
VLOAD: Q1.2 (D), Q2.2 (D), Q3.2 (D), Q4.2 (D); also elsewhere on the board
VSENSE: U4.8 (Vbus), U5.8 (Vbus), U7.8 (Vbus), U8.8 (Vbus); also elsewhere on the board
VSET1: C5.1, R12.2, R13.1, U3.3 (+); also elsewhere on the board
VSET2: C8.1, R18.2, R19.1, U3.5 (+); also elsewhere on the board
VSET3: C11.1, R24.2, R25.1, U6.3 (+); also elsewhere on the board
VSET4: C14.1, R30.2, R31.1, U6.5 (+); also elsewhere on the board

Notes on the sheet:
Channel 1 - 0-5 A, 75 W - INA228 @0x40
Channel 2 - 0-5 A, 75 W - INA228 @0x41
Channel 3 - 0-5 A, 75 W - INA228 @0x42
Channel 4 - 0-5 A, 75 W - INA228 @0x43
Op-amp supply

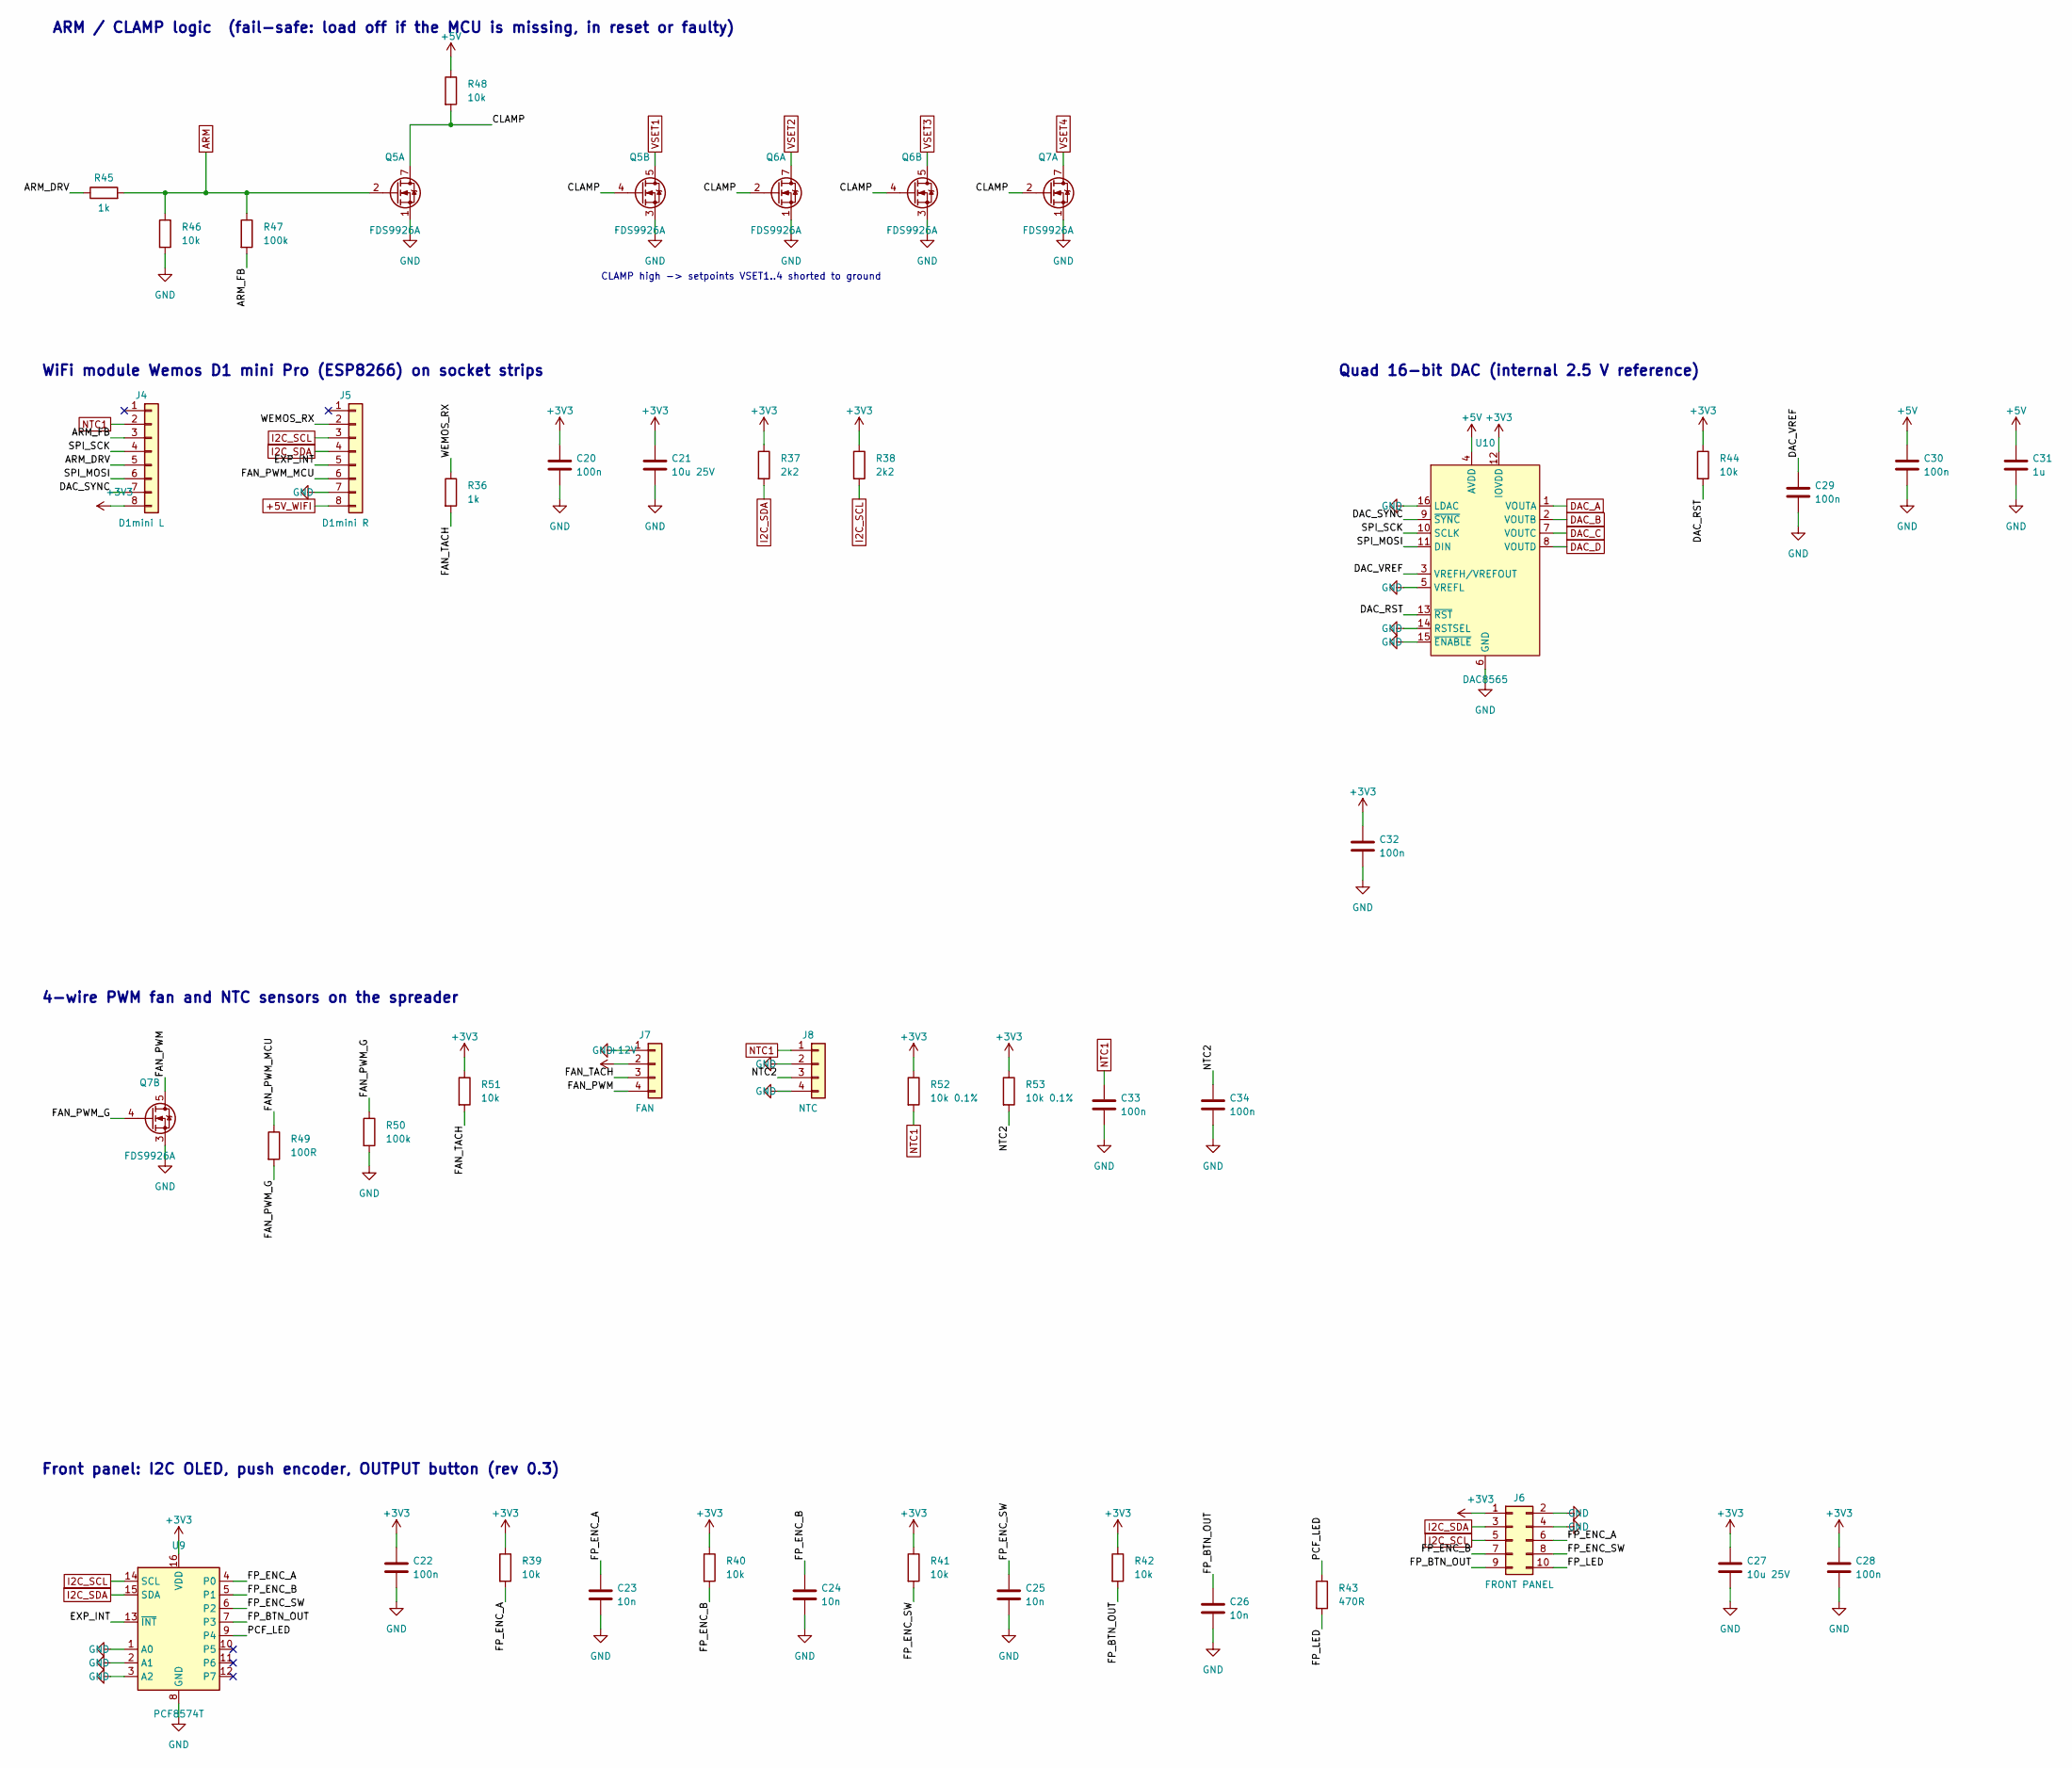
[picture p41: schematic control.kicad_sch, Electronic Load 4ch 60V 20A 300W — Control]

Parts:
C20, C22, C28, C29, C30, C32, C33, C34: 100n; C_1206_3216Metric
C21, C27: 10u 25V; C_1206_3216Metric
C23, C24, C25, C26: 10n; C_1206_3216Metric
C31: 1u; C_1206_3216Metric
J4: D1mini L; PinSocket_1x08_P2.54mm_Vertical
J5: D1mini R; PinSocket_1x08_P2.54mm_Vertical
J6: FRONT PANEL; IDC-Header_2x05_P2.54mm_Vertical
J7: FAN; Molex_KK-254_AE-6410-04A_1x04_P2.54mm_Vertical
J8: NTC; Molex_KK-254_AE-6410-04A_1x04_P2.54mm_Vertical
Q5, Q6, Q7: FDS9926A; SOIC-8_3.9x4.9mm_P1.27mm; MPN FDS9926A
R36, R45: 1k; R_1206_3216Metric
R37, R38: 2k2; R_1206_3216Metric
R39, R40, R41, R42, R44, R46, R48, R51: 10k; R_1206_3216Metric
R43: 470R; R_1206_3216Metric
R47, R50: 100k; R_1206_3216Metric
R49: 100R; R_1206_3216Metric
R52, R53: 10k 0.1%; R_1206_3216Metric
U9: PCF8574T; SOIC-16W_7.5x10.3mm_P1.27mm; MPN PCF8574T/3
U10: DAC8565; TSSOP-16_4.4x5mm_P0.65mm; MPN DAC8565IAPW

Connections:
+3V3: C20.1, C21.1, C22.1, C27.1, C28.1, C32.1, J4.8, J6.1, R37.1, R38.1, R39.1, R40.1, R41.1, R42.1, R44.1, R51.1, R52.1, R53.1, U9.16 (VDD), U10.12 (IOVDD); also elsewhere on the board
+5V: C30.1, C31.1, R48.1, U10.4 (AVDD); also elsewhere on the board
+5V_WIFI: J5.8; also elsewhere on the board
+12V: J7.2; also elsewhere on the board
/Control/ARM_DRV: J4.5, R45.1
/Control/ARM_FB: J4.3, R47.2
/Control/CLAMP: Q5.4 (G2), Q5.7 (D1), Q5.8 (D1), Q6.2 (G1), Q6.4 (G2), Q7.2 (G1), R48.2
/Control/DAC_RST: R44.2, U10.13 (~RST)
/Control/DAC_SYNC: J4.7, U10.9 (~SYNC)
/Control/DAC_VREF: C29.1, U10.3 (VREFH/VREFOUT)
/Control/EXP_INT: J5.5, U9.13 (~INT)
/Control/FAN_PWM: J7.4, Q7.5 (D2), Q7.6 (D2)
/Control/FAN_PWM_G: Q7.4 (G2), R49.2, R50.1
/Control/FAN_PWM_MCU: J5.6, R49.1
/Control/FAN_TACH: J7.3, R36.2, R51.2
/Control/FP_BTN_OUT: C26.1, J6.9, R42.2, U9.7 (P3)
/Control/FP_ENC_A: C23.1, J6.6, R39.2, U9.4 (P0)
/Control/FP_ENC_B: C24.1, J6.7, R40.2, U9.5 (P1)
/Control/FP_ENC_SW: C25.1, J6.8, R41.2, U9.6 (P2)
/Control/FP_LED: J6.10, R43.2
/Control/NTC2: C34.1, J8.3, R53.2
/Control/PCF_LED: R43.1, U9.9 (P4)
/Control/SPI_MOSI: J4.6, U10.11 (DIN)
/Control/SPI_SCK: J4.4, U10.10 (SCLK)
/Control/WEMOS_RX: J5.2, R36.1
ARM: Q5.2 (G1), R45.2, R46.1, R47.1; also elsewhere on the board
DAC_A: U10.1 (VOUTA); also elsewhere on the board
DAC_B: U10.2 (VOUTB); also elsewhere on the board
DAC_C: U10.7 (VOUTC); also elsewhere on the board
DAC_D: U10.8 (VOUTD); also elsewhere on the board
GND: C20.2, C21.2, C22.2, C23.2, C24.2, C25.2, C26.2, C27.2, C28.2, C29.2, C30.2, C31.2, C32.2, C33.2, C34.2, J5.7, J6.2, J6.4, J7.1, J8.2, J8.4, Q5.1 (S1), Q5.3 (S2), Q6.1 (S1), Q6.3 (S2), Q7.1 (S1), Q7.3 (S2), R46.2, R50.2, U9.1 (A0), U9.2 (A1), U9.3 (A2), U9.8 (GND), U10.5 (VREFL), U10.6 (GND), U10.14 (RSTSEL), U10.15 (~ENABLE), U10.16 (LDAC); also elsewhere on the board
I2C_SCL: J5.3, J6.5, R38.2, U9.14 (SCL); also elsewhere on the board
I2C_SDA: J5.4, J6.3, R37.2, U9.15 (SDA); also elsewhere on the board
NTC1: C33.1, J4.2, J8.1, R52.2; also elsewhere on the board
VSET1: Q5.5 (D2), Q5.6 (D2); also elsewhere on the board
VSET2: Q6.7 (D1), Q6.8 (D1); also elsewhere on the board
VSET3: Q6.5 (D2), Q6.6 (D2); also elsewhere on the board
VSET4: Q7.7 (D1), Q7.8 (D1); also elsewhere on the board

Notes on the sheet:
ARM / CLAMP logic (fail-safe: load off if the MCU is missing, in reset or faulty)
CLAMP high -> setpoints VSET1..4 shorted to ground
WiFi module Wemos D1 mini Pro (ESP8266) on socket strips
Front panel: I2C OLED, push encoder, OUTPUT button (rev 0.3)
Quad 16-bit DAC (internal 2.5 V reference)
4-wire PWM fan and NTC sensors on the spreader

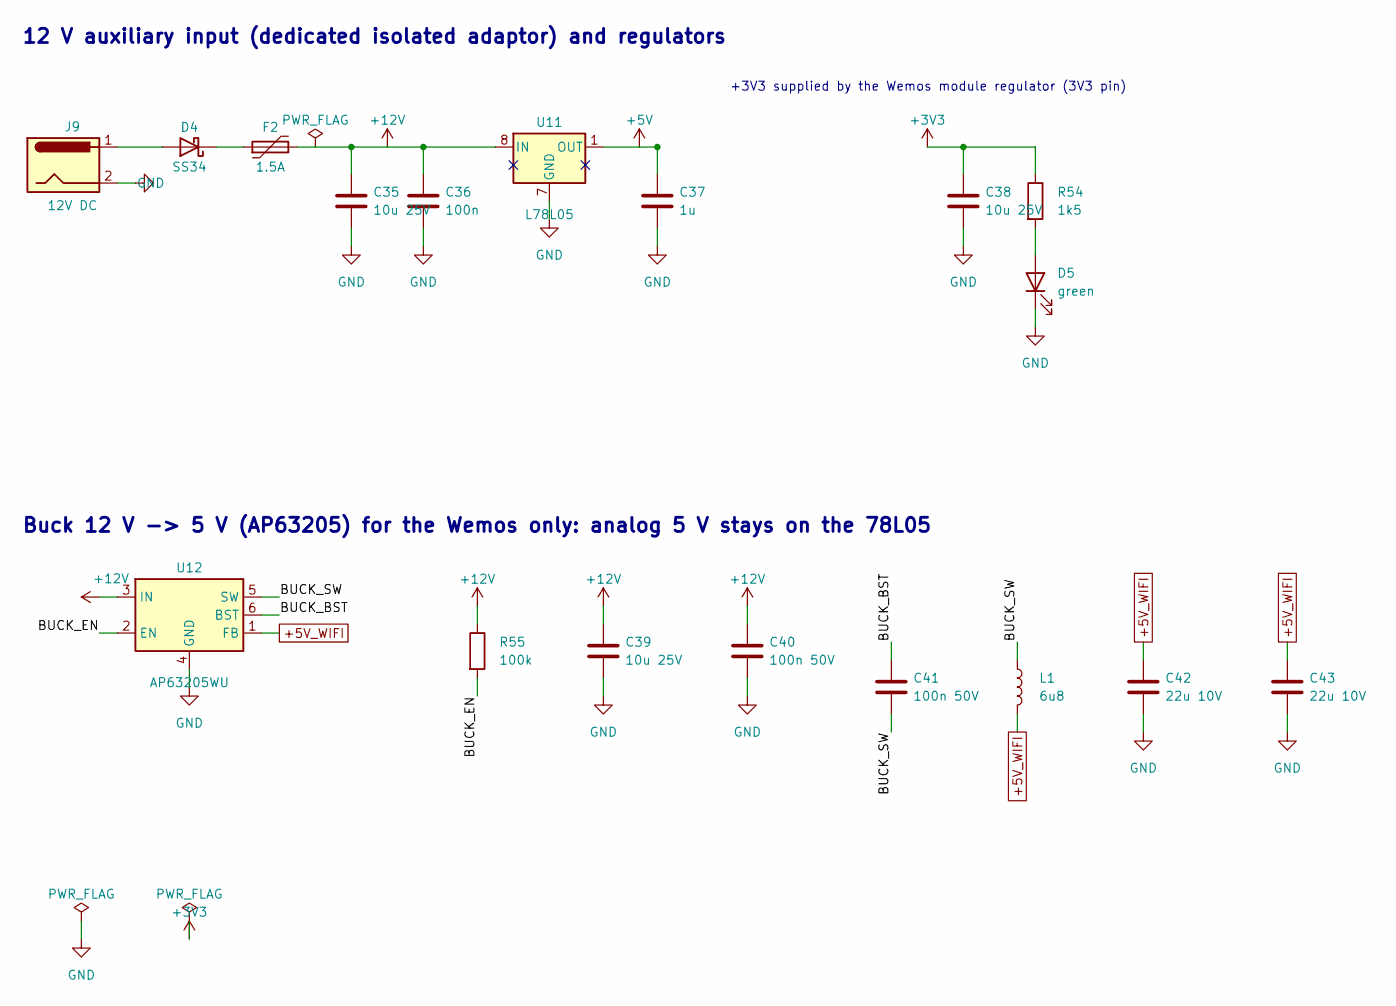
[picture p42: schematic power.kicad_sch, Electronic Load 4ch 60V 20A 300W — Power supplies]

Parts:
C35, C38, C39: 10u 25V; C_1206_3216Metric
C36: 100n; C_1206_3216Metric
C37: 1u; C_1206_3216Metric
C40, C41: 100n 50V; C_1206_3216Metric
C42, C43: 22u 10V; C_1206_3216Metric
D4: SS34; D_SMA; MPN SS34
D5: green; LED_1206_3216Metric
F2: 1.5A; Fuse_1206_3216Metric
J9: 12V DC; BarrelJack_Horizontal
L1: 6u8; L_Bourns-SRN4018; MPN SRN4018-6R8M
R54: 1k5; R_1206_3216Metric
R55: 100k; R_1206_3216Metric
U11: L78L05; SOIC-8_3.9x4.9mm_P1.27mm; MPN L78L05ACD13TR
U12: AP63205WU; TSOT-23-6; MPN AP63205WU-7

Connections:
+3V3: C38.1, R54.1; also elsewhere on the board
+5V: C37.1, U11.1 (OUT); also elsewhere on the board
+5V_WIFI: C42.1, C43.1, L1.2, U12.1 (FB); also elsewhere on the board
+12V: C35.1, C36.1, C39.1, C40.1, F2.2, R55.1, U11.8 (IN), U12.3 (IN); also elsewhere on the board
/Power supplies/BUCK_BST: C41.1, U12.6 (BST)
/Power supplies/BUCK_EN: R55.2, U12.2 (EN)
/Power supplies/BUCK_SW: C41.2, L1.1, U12.5 (SW)
GND: C35.2, C36.2, C37.2, C38.2, C39.2, C40.2, C42.2, C43.2, D5.1 (K), J9.2, U11.2 (GND), U11.3 (GND), U11.6 (GND), U11.7 (GND), U12.4 (GND); also elsewhere on the board
unnamed: D4.2 (A), J9.1
unnamed: D4.1 (K), F2.1
unnamed: D5.2 (A), R54.2

Notes on the sheet:
12 V auxiliary input (dedicated isolated adaptor) and regulators
+3V3 supplied by the Wemos module regulator (3V3 pin)
Buck 12 V -> 5 V (AP63205) for the Wemos only: analog 5 V stays on the 78L05

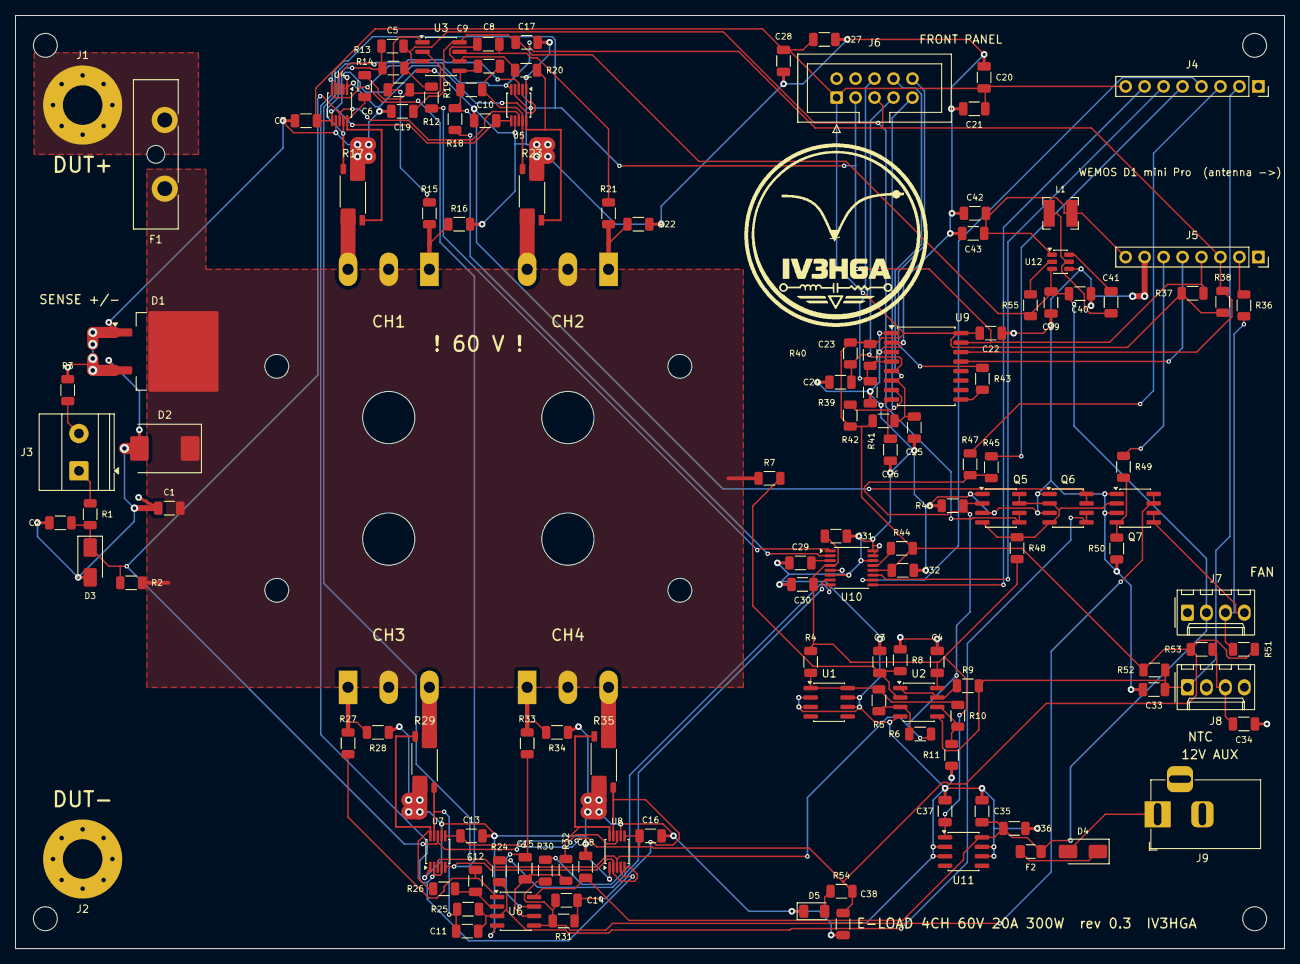
[picture p43: board eload_4ch.kicad_pcb from above]

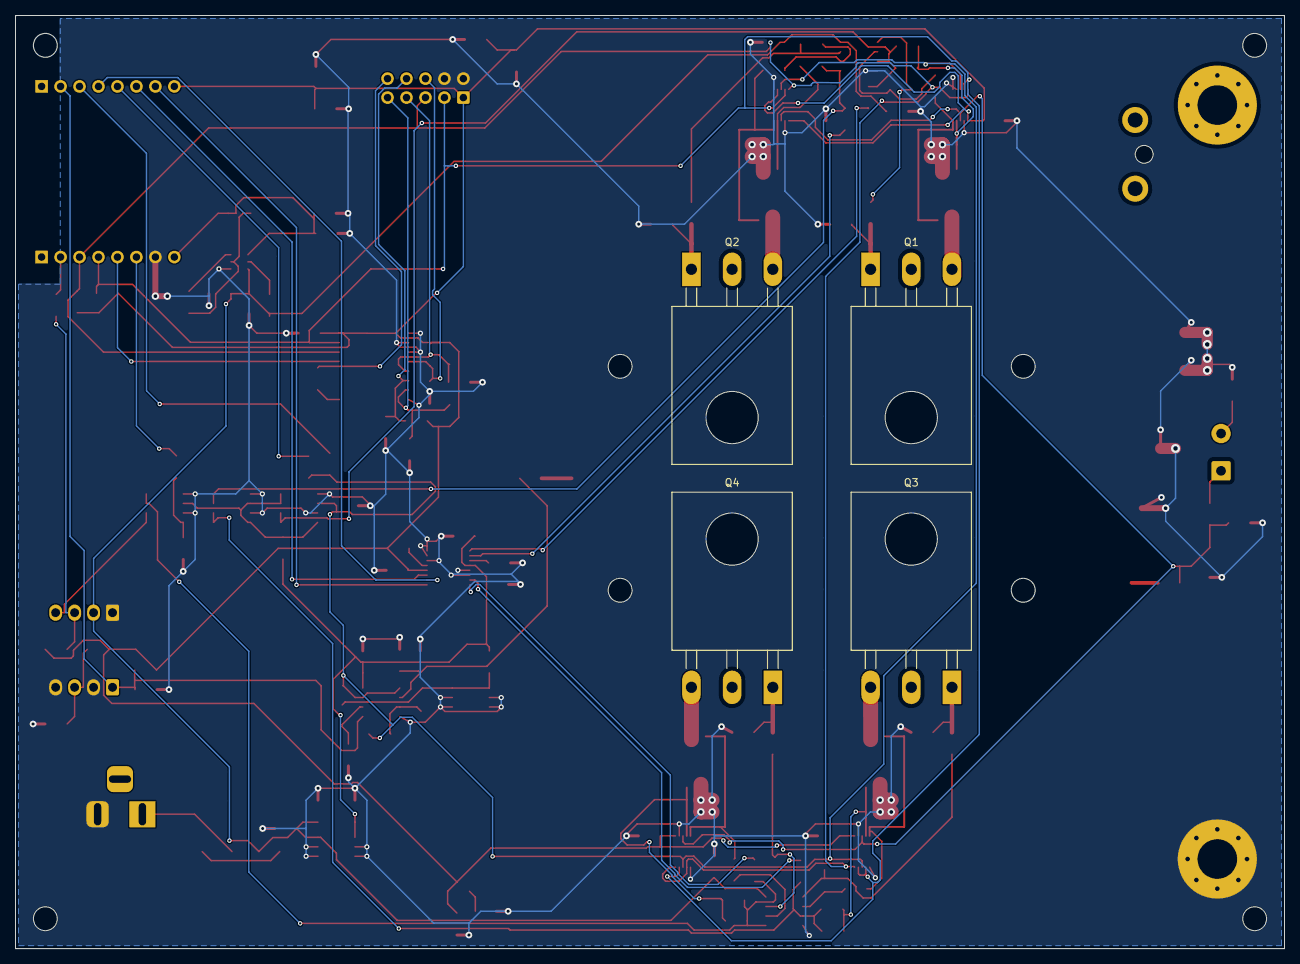
[picture p44: board eload_4ch.kicad_pcb from below]

Board: 2 copper layers, 170.0 x 125.0 mm, 143 parts (4 on the bottom side), 77 nets.

Other parts of the board:
H1, H2, H3, H4: M3; MountingHole_3.2mm_M3
H5, H6, H7, H8: M3 nylon (spreader); MountingHole_3.2mm_M3
LOGO1: Logo_IV3HGA; Logo_IV3HGA_25mm
