metallarox/eload-60v/firmware/eload/logo_xbm.h

// IV3HGA logo, 64x64 XBM for the OLED splash screen (generated from the silkscreen version)
#pragma once
#include <Arduino.h>
#define LOGO_W 64
#define LOGO_H 64
static const unsigned char logo_xbm[] PROGMEM = {
  0x00, 0x00, 0x00, 0xc0, 0x03, 0x00, 0x00, 0x00, 0x00, 0x00, 0x00, 0xff, 0xff, 0x00, 0x00, 0x00,
  0x00, 0x00, 0xe0, 0x07, 0xe0, 0x07, 0x00, 0x00, 0x00, 0x00, 0x7c, 0xf8, 0x1f, 0x3e, 0x00, 0x00,
  0x00, 0x00, 0x8e, 0x0f, 0xf0, 0xf1, 0x00, 0x00, 0x00, 0x80, 0xf3, 0x00, 0x00, 0xcf, 0x01, 0x00,
  0x00, 0xe0, 0x1c, 0x00, 0x00, 0x38, 0x07, 0x00, 0x00, 0x70, 0x06, 0x00, 0x00, 0xe0, 0x0e, 0x00,
  0x00, 0x98, 0x01, 0x00, 0x00, 0x80, 0x19, 0x00, 0x00, 0xcc, 0x00, 0x00, 0x00, 0x00, 0x33, 0x00,
  0x00, 0x26, 0x00, 0x00, 0x00, 0x00, 0x6c, 0x00, 0x00, 0x13, 0x00, 0x00, 0x00, 0x00, 0xd8, 0x00,
  0x80, 0x09, 0x00, 0x00, 0x00, 0x00, 0xb0, 0x01, 0xc0, 0x04, 0x00, 0x00, 0x00, 0x00, 0x20, 0x03,
  0xc0, 0x02, 0x00, 0x00, 0x00, 0x00, 0x60, 0x03, 0x60, 0x03, 0x00, 0x00, 0x00, 0x00, 0xc0, 0x06,
  0x20, 0x01, 0x00, 0x00, 0x00, 0x00, 0x90, 0x0d, 0xb0, 0x00, 0x00, 0x00, 0x00, 0x00, 0xfc, 0x0d,
  0xd8, 0xe0, 0x07, 0x00, 0x00, 0xf8, 0x7f, 0x1b, 0x58, 0x00, 0x7c, 0x00, 0x00, 0x0e, 0x10, 0x1a,
  0x68, 0x00, 0xc0, 0x00, 0x80, 0x01, 0x00, 0x16, 0x2c, 0x00, 0x00, 0x03, 0xc0, 0x00, 0x00, 0x34,
  0x2c, 0x00, 0x00, 0x02, 0x60, 0x00, 0x00, 0x34, 0x14, 0x00, 0x00, 0x04, 0x30, 0x00, 0x00, 0x2c,
  0x16, 0x00, 0x00, 0x08, 0x18, 0x00, 0x00, 0x68, 0x16, 0x00, 0x00, 0x08, 0x08, 0x00, 0x00, 0x68,
  0x16, 0x00, 0x00, 0x10, 0x0c, 0x00, 0x00, 0x58, 0x1a, 0x00, 0x00, 0x10, 0x04, 0x00, 0x00, 0x58,
  0x0a, 0x00, 0x00, 0x20, 0x06, 0x00, 0x00, 0x50, 0x0a, 0x00, 0x00, 0x20, 0x02, 0x00, 0x00, 0xd0,
  0x0b, 0x00, 0x00, 0xe0, 0x03, 0x00, 0x00, 0xd0, 0x0b, 0x00, 0x00, 0xc0, 0x01, 0x00, 0x00, 0xd0,
  0x0b, 0x00, 0x00, 0xc0, 0x01, 0x00, 0x00, 0xd0, 0x0b, 0x00, 0x00, 0xc0, 0x00, 0x00, 0x00, 0xd0,
  0x0a, 0x00, 0x00, 0x00, 0x00, 0x00, 0x00, 0xd8, 0x1a, 0x00, 0x00, 0x00, 0x00, 0x00, 0x00, 0x58,
  0x1a, 0x00, 0x00, 0x00, 0x00, 0x00, 0x00, 0x58, 0x16, 0x00, 0x00, 0x00, 0x00, 0x00, 0x00, 0x58,
  0x16, 0x00, 0x00, 0x00, 0x00, 0x00, 0x00, 0x68, 0x36, 0x00, 0x00, 0x00, 0x00, 0x00, 0x00, 0x6c,
  0x34, 0xc0, 0xc7, 0xdf, 0xec, 0xe7, 0x01, 0x6c, 0x2c, 0xc0, 0xe6, 0xff, 0xec, 0xe7, 0x01, 0x3c,
  0x6c, 0xc0, 0x6e, 0xf8, 0x6c, 0xe0, 0x01, 0x36, 0x68, 0xc0, 0x7e, 0xde, 0x6f, 0xf7, 0x03, 0x36,
  0xd8, 0xc0, 0x7c, 0xf8, 0x6f, 0xf7, 0x03, 0x1b, 0xd8, 0xc0, 0x3c, 0xff, 0xec, 0xf7, 0x07, 0x1b,
  0xb0, 0xc1, 0x3c, 0xdf, 0xec, 0x3f, 0x87, 0x0d, 0xb0, 0x03, 0x00, 0x00, 0x00, 0x00, 0xc0, 0x0d,
  0x60, 0x63, 0x00, 0x00, 0x01, 0x00, 0xe2, 0x06, 0xc0, 0xe6, 0xf8, 0x87, 0xa1, 0x02, 0x65, 0x03,
  0xc0, 0xbc, 0xa0, 0xfa, 0x5f, 0x0f, 0x3d, 0x03, 0x80, 0x7d, 0x00, 0x80, 0x01, 0x00, 0xbe, 0x01,
  0x00, 0x3b, 0x00, 0x00, 0x00, 0x00, 0xdc, 0x00, 0x00, 0xf6, 0xf8, 0x7f, 0xfa, 0x1f, 0x6f, 0x00,
  0x00, 0xcc, 0xc1, 0x5f, 0xfa, 0x83, 0x33, 0x00, 0x00, 0x98, 0x87, 0x9f, 0xf9, 0xe1, 0x19, 0x00,
  0x00, 0x70, 0x1f, 0x80, 0x01, 0xf8, 0x0e, 0x00, 0x00, 0xe0, 0x7c, 0x00, 0x00, 0x3e, 0x07, 0x00,
  0x00, 0x80, 0xf3, 0x07, 0xe0, 0xcf, 0x01, 0x00, 0x00, 0x00, 0x8f, 0xff, 0xff, 0xf3, 0x00, 0x00,
  0x00, 0x00, 0x7c, 0xfc, 0x3f, 0x3e, 0x00, 0x00, 0x00, 0x00, 0xe0, 0x03, 0xc0, 0x0f, 0x00, 0x00,
  0x00, 0x00, 0x00, 0xff, 0xff, 0x01, 0x00, 0x00, 0x00, 0x00, 0x00, 0xe0, 0x07, 0x00, 0x00, 0x00,
};
