metallarox/eload-60v/(commit log)

2026-10-26 eload-4ch-60v rev 0.2: 4-channel 60 V / 20 A / 300 W electronic load
    KiCad 10 project, gerbers, priced BOM, circuit walkthrough slides,
    loop-stability and SOA analysis. CERN-OHL-S-2.0 (hardware), MIT (software).
    Claude-Session: https://claude.ai/code/session_013KrwoEq2Y4F9LNKutY5RJ4
    [alimentazione.kicad_sch, canali.kicad_sch, controllo.kicad_sch, eload_4ch.kicad_pcb, eload_4ch.kicad_sch, eload_4ch_bom.csv, eload_4ch_bom_priced.xlsx, eload_4ch_positions.csv]
2026-10-26 rev 0.3: front panel with I2C OLED, encoder and OUTPUT button
    PCF8574 expander (0x20) with INT on GPIO0, 10-pin IDC connector,
    RC debounce, I2C pull-ups 2.2k, re-routed PCB (DRC/parity clean),
    updated BOM, slides (front panel page) and README.
    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
    [alimentazione.kicad_sch, canali.kicad_sch, controllo.kicad_sch, eload_4ch.kicad_pcb, eload_4ch.kicad_sch, eload_4ch_bom.csv, eload_4ch_bom_priced.xlsx, eload_4ch_positions.csv]
2026-10-26 Translate schematic and PCB to English
    Sheets renamed (input, channels, control, power), all titles, notes,
    values and board texts in English; symbol library renamed to eload.
    Re-routed board: DRC with schematic parity clean.
    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
    [canali.kicad_sch, channels.kicad_sch, control.kicad_sch, eload_4ch.kicad_pcb, eload_4ch.kicad_sch, eload_4ch_bom.csv, eload_4ch_positions.csv, input.kicad_sch]
2026-10-26 Clean silkscreen and add assembly aids
    Reference designators repositioned next to their parts with no overlap
    on pads, other silkscreen or component bodies (relabel.py); dangling
    track stubs cleaned (cleanup.py). DRC: only the 4 intentional MOSFET
    footprint overrides remain. Added interactive HTML BOM and top/bottom
    assembly drawings.
    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
    [eload_4ch.kicad_pcb, eload_4ch_positions.csv]
2026-10-26 Add IV3HGA logo to schematic sheets and PCB silkscreen
    Logo next to the title block on every sheet; 25 mm silkscreen version
    (board-only footprint eload:Logo_IV3HGA_25mm in the project library).
    ERC/DRC unchanged: no silkscreen overlaps, schematic parity clean.
    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
    [channels.kicad_sch, control.kicad_sch, eload_4ch.kicad_pcb, eload_4ch.kicad_sch, input.kicad_sch, power.kicad_sch]
2026-10-26 Firmware 0.1.0: control, protections, OLED/encoder panel, CSV logging, web UI, OTA
    - INA228 / DAC8565 drivers, CC/CP/CR with channel distribution and keep-alive
    - Software protections (OVP, OCP, OPP, OTP, Vmax, cutoff) on top of the ARM/CLAMP chain
    - Front panel: SSD1309/SH1106 OLED, EC11 encoder, OUTPUT button with LED
    - Logging: RAM history (600 samples) and CSV on LittleFS
    - Web UI with live chart, calibration, WiFi setup, OTA update
    - Host unit tests and mock server
    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
2026-10-26 Firmware 0.2.0: pulsed load with adjustable frequency and duty
    - Sink alternates between the setpoint and the 10 mA keep-alive, 0.1 Hz - 1 kHz,
    duty 1 - 99 %, each phase >= 100 us (loop edges ~30-50 us)
    - Timer1 (waveform NMI) callback writes the DAC over raw HSPI, double-buffered levels
    - INA228 switched to bus+shunt, 128 averages in pulsed mode (true averages > ~20 Hz)
    - Front-panel menu (long push): mode, pulse on/off, frequency, duty
    - Web: pulse controls, presets, waveform preview; API pulse/freq/duty; CSV columns
    - Unit tests for pulse timing, host renderer for the OLED screens
    Claude-Session: https://claude.ai/code/session_013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
